Cody-ic/fpga-air-haptics/hardware/mechanical/P4_20261007/vertical_wrist.png

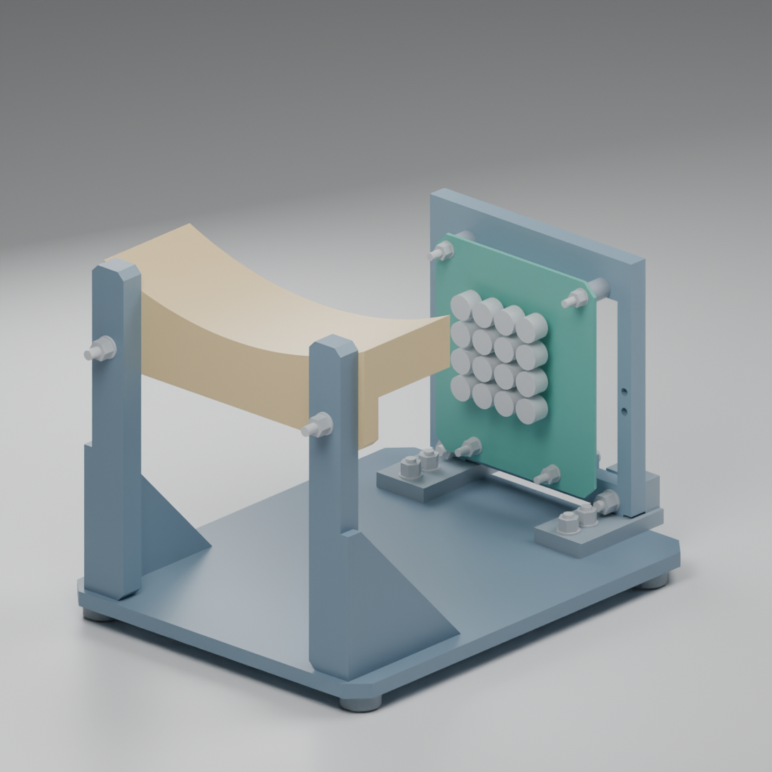
hardware/mechanical/P4_20261007/vertical_wrist.png
