Cody-ic/fpga-air-haptics/hardware/Haptics_4x4_R4_12VDC/核验报告.md

# 4×4 超声发射端 R4：12 V 电源保护与测试点

核验日期：2026-09-26。基于 R3 的独立副本修改，原始上传文件及 R3 保留。

## 修改内容

- **U25 改为 AMASS XT30PW-M20.G.Y 公头**，型号中的 `M` 表示公头。电源线端配套使用母头，避免带电线端露出金属针。原理图符号、PCB 封装和器件信息同时更新；重新调整安装位置及走线，使插接口朝向板边。
- 新增 **F1：0454.500MR，0.5 A 保险丝**；新增 **RT1：10D-9，冷态标称 10 Ω 的 NTC**，用于限制输入电容充电电流。
- 新增 **D1：SMBJ13A-13-F 单向 TVS**，阴极接保护后的 VCC，阳极接 GND。
- 新增 **19 个底面测试焊盘**：VIN、VCC、GND，以及 T00–T15。输出测试点通过短线接入对应输出网络，直径 1.524 mm，开放阻焊、不设置锡膏开口。
- 丝印更新为 R4，增加输入正负极与保险丝额定值。公头库封装中重复覆盖焊盘的铜层圆线移到文档层；保留焊盘、钻孔及机械位置。

## 电源与测试点

```text
U25.1 (+) → VIN_12V → F1 → VIN_FUSED → RT1 → VCC → C1 / 驱动器
                                                   └→ D1.K
U25.2 (-) → GND                                      D1.A → GND
```

| 测试点 | 连接网络 | 用途 |
| --- | --- | --- |
| VIN | VIN_12V | 测量保险丝前的输入电压 |
| VCC | VCC | 测量保护后的驱动电压及纹波 |
| GND | GND | 测量参考地 |
| T00–T15 | OUT0–OUT15 | 逐路检查输出频率、相位、幅度及过冲 |

U25 的 3、4 脚为封装固定脚，在原理图中标记不连接。未新增电子反接保护；XT30 的机械防呆不能防止线束正负极焊反。

## 软件核验

- 嘉立创 EDA Pro 严格原理图 DRC 与 PCB DRC 均为 **0 条错误**。
- 对比 78 个器件的原理图、PCB 引脚网络及封装关联，一致；保护链路已串入供电网络。
- 导出工程保留四个新增或替换器件；除 U25 外，原有 74 个器件的封装焊盘和孔几何与 R3 一致。
- Gerber 核查：19 个测试点均有底面阻焊开口，无对应锡膏闪孔；XT30 电源脚孔径约 1.90 mm，固定脚孔径约 1.10 mm。
- 保留 80 × 88 mm、4 层板、4×4 MA40S4S 阵列和原通道映射。当前有 93 个通孔过孔，以及原有 **32 个盲孔**：顶层至内层 1 为 8 个，内层 1 至底层为 24 个。生产需匹配该工艺，不能按普通全通孔四层板下单。

## 实物验证边界

本版完成设计文件核验，尚无实物测试。F1 的 0.5 A 为首版选值，需结合实际工作电流、启动电流及温升确认。NTC 会产生压降，热态再次上电时限流能力减弱；应同时测 VIN 和 VCC。

SMBJ13A 的反向工作电压为 13 V，数据手册额定脉冲下的最大钳位电压为 21.5 V；TC4427A 工作上限为 18 V、绝对最大值为 22 V。因此这里只将其作为小能量瞬态抑制措施，**不能宣称额定浪涌全范围保护，也不能接入 24 V 电源**。布线寄生与实际过冲仍需测量。

首次上电使用限流的 12 V 电源，先检查静态电流与 VCC，再逐通道检查 40 kHz 波形。输出为单端驱动，幅度取决于实际 VCC；声压、触觉效果及连续工作温升未验证。

## 文件

- [可编辑 EPRO 工程](Haptics_4x4_R4_12VDC.epro)
- [Gerber 复核文件](Haptics_4x4_R4_12VDC_Gerber.zip)
- [电源原理图](电源原理图.png)

## 9. 参考资料

- Microchip，2014：[TC4426A/TC4427A/TC4428A，DS20001423J](https://ww1.microchip.com/downloads/en/DeviceDoc/20001423J.pdf)，供电范围、绝对最大值及输入门限。
- Diodes，2017-05：[SMBJ5.0A–SMBJ200CA，DS19002 Rev. 20-2](https://www.diodes.com/assets/Datasheets/ds19002.pdf)，SMBJ13A 电压与脉冲参数。
- RUILON：[NTC 浪涌抑制器数据手册](https://atta.szlcsc.com/upload/public/pdf/source/20180410/C207392_007A1CB20DB6E487C695D7783FF0F5F9.pdf)，10D-9 参数。链接上传路径日期不等于厂商出版日期。
- 嘉立创器件库：XT30PW-M20.G.Y（C30170175）、0454.500MR（C179003）、10D-9（C70924）、SMBJ13A-13-F（C135042）；选型与封装资料核对日期为 2026-09-26。
