Cody-ic/fpga-air-haptics/hardware/mechanical/P5_lifts20_20261025/打印说明.txt

20 mm 增高垫打印说明（2026-10-25）

共2件，每个文件打印1个，按毫米单位、100%比例打印：
1. 13_receiver_tray_lift20.stl：接收板原托盘的增高垫，82.8×61.419×22 mm。
2. 14_film_stand_lift20.stl：薄膜原支架的增高垫，128.8×154.8×22 mm。

两件承托面都高20 mm，顶部另有2 mm定位挡边，所以文件总高22 mm。
平底朝下、挡边朝上；普通硬质塑料，建议层高0.2 mm、4道外壁、20%～25%填充、顶部和底部至少5层。无需支撑，保留薄膜垫中央的开口。

接收板继续固定在原05_receiver_flat_tray托盘内，整套托盘放到13号垫子上，不能把裸电路板直接放在新垫子上。
薄膜继续夹在原上下夹框内，连同原10_film_lower_stand四个脚一起放到14号垫子上；不要把膜片直接铺在新垫子上。
每次只放接收端或薄膜其中一种，不能叠放这两个新垫子。无需新螺丝、胶水或在原件上钻孔。
