Cody-ic/fpga-air-haptics/设计思路.md

# 触见：超声触觉图形显示器——设计思路

更新日期：2026-09-24

本文记录团队当前讨论形成的方案，用于分工、选型和联调。`desktop_app/` 已有可运行上位机、Demo 和双向串口客户端；FPGA、驱动及阵列仍为设计计划，尚无硬件实测。本文明确区分软件实现、参考模型和待验证目标，参数与接口需在联调后冻结。

## 1. 项目目标与范围

面向视障人群对基础图形和方向信息的感知需求，探索把简单形状和运动轨迹转化为手掌可感知的超声触觉刺激。首阶段验证“是否感觉得到、是否能区分简单图形”，不预先承诺复杂地图、精细轮廓或成熟无障碍产品能力。

| 已明确的方向 | 实现上仍待确定 |
|---|---|
| 主控选用 Tang Mega 60K，核心实时逻辑放在 FPGA | 实际底板版本、可用 GPIO、定点算法与时钟配置 |
| 保留外接 PCB 按键，预设图形可独立选择与播放 | 按键数量、指示方式、连接器和引脚 |
| 上位机采用 Python/Tk，HAP3 坐标路径协议已有客户端与 Demo | FPGA 固件实现、硬件回传时序与测量接口 |
| 以单焦点沿完整轮廓高速循环扫描为首版路线 | 工作高度、扫描参数、手部运动影响及可辨识图形 |
| 硬件先做 4×4，再扩展 8×8，256 路作为后续方向 | 换能器、驱动电路、模块尺寸及最终阵列规模 |
| 首版拟用可调腕托／定位凹槽与操作语音帮助放手 | 结构、工作高度、不同手型适配及语音播放载体 |

Tang Mega 60K 是 Sipeed 推出的开发板，使用高云 FPGA。GPIO 电平与接口复用应以实际板卡原理图为准，不能把不同连接器上的复用信号重复计数。资料入口见第 9 节。[1]

## 2. 系统架构

```mermaid
flowchart TD
    KEY[外接按键与状态指示 PCB] --> CTRL[模式仲裁与运行控制]
    PC[电脑上位机：配置、声场预测、数据分析] <-->|USB-UART| UART[串口解析与状态回传]
    UART <--> CTRL
    CTRL --> TRACK[预设图形存储与轨迹生成]
    TRACK --> PHASE[板内相位计算与校准补偿]
    PHASE --> BUF[相位双缓冲与统一更新]
    BUF --> OUT[载波、触觉调制及输出扩展]
    OUT --> DRIVER[独立驱动电路]
    DRIVER --> ARRAY[超声换能器阵列]
    CTRL -->|输出使能| OUT
    RX[接收器、测量前端与可选 ADC] -.扫描数据.-> PC
```

测量链路的接入方式尚未确定：初期可由示波器记录并导入电脑，后期再评估由 ADC 采样、FPGA 整理后经串口回传。没有测量硬件时，上位机只能显示计算结果和数字运行状态。

### 2.1 FPGA 和电脑的分工

- **FPGA**：处理按键与命令，执行轨迹，计算各通道相位，完成统一更新、载波输出和触觉调制；保存必要的运行状态。
- **电脑**：设置参数、选择图形、预览声场、下载轨迹、查看回传状态和分析测量数据。界面刷新与硬件实时输出解耦。
- **驱动电路**：把控制信号转换成适合所选换能器的电气激励。供电、电流能力和负载波形需单独验证。

独立运行是功能要求，但“拔掉电脑仍播放”本身不能证明相位计算发生在 FPGA。应通过 RTL 仿真、板端中间结果和资源报告说明计算实现；预存轨迹点与预存完整相位表也应明确区分。

### 2.2 本地模式与联机模式

下列规则已在上位机与 Demo 中体现，真实固件仍需实现与验证。

| 项目 | 本地独立模式 | 联机调试模式 |
|---|---|---|
| 配置入口 | 外接按键和板内预设 | 电脑串口 |
| 实时轨迹与相位计算 | FPGA | FPGA |
| 电脑断开 | 不影响已启动的本地任务 | 电脑尝试发送停止；板端心跳超时停止，Demo 阈值为 3 秒 |
| 图形来源 | 板内 ROM 或片内存储器 | 预设图形或一次下载并确认完整的轨迹 |
| 停止入口 | 本地停止键 | 本地停止键和串口停止命令 |

建议只允许在待机状态切换控制模式。本地停止键优先于所有启动命令；上电、复位后保持输出关闭，重新启动必须经过明确操作。串口连接或软件重连不能自动启动阵列。

## 3. FPGA 内部设计

### 3.1 数据通路

建议按下列边界拆分模块，具体命名在建立 RTL 工程时确定：

1. **输入与状态机**：按键同步及消抖、串口解析、模式仲裁、运行与错误状态。
2. **轨迹发生器**：上位机已有固定点、水平线、竖直线、圆、正方形、三角形和箭头；板端按验证进度逐项实现。参数包括中心、尺寸、播放速度和焦点高度。
3. **相位求解器**：由阵元坐标和目标坐标计算传播距离、相位，再叠加校准补偿；定点实现与电脑参考模型逐项对照。[3]
4. **缓冲与同步**：后台计算下一组相位，完整后统一切换；明确更新时刻，避免不同通道使用不同代参数。
5. **波形与调制**：产生载波与调制时序，协调输出使能；相位跳变和异常命令下的波形必须检查。
6. **状态回传**：返回当前模式、图形、已生效参数、相位更新计数、错误码及协议版本。

40 kHz 载波、至少 64 级相位量化、1～10 kHz 相位更新率可作为首轮评估参数，均不是已实现指标，也不作为触觉效果保证。最终选择取决于换能器、计算延迟、输出链路和测量结果。

区分三种频率：载波频率、相位更新率、整条轨迹重复率。例如每圈 100 个点、每秒更新 10,000 个点，在逐点匀速执行且无停顿时每秒重复 100 圈；不能把 10 kHz 写成图形重复率。

### 3.2 GPIO 扩展

先做真实的引脚分配表，再决定直连与并行移位链的比例。输出扩展应支持统一锁存或等效的同步更新，不预先固定“一个换能器占一个 FPGA 引脚”。

若采用逐时间片发送通道电平的移位方案，带宽预算为：

```text
单链净移位速率 = 每条链通道数 × 载波频率 × 每周期时间片数
示例：8 × 40,000 × 64 = 20.48 Mbit/s
```

该数值只计算有效数据，还需预留锁存和器件时序余量。若下级器件独立生成波形，必须按另一种接口重新计算。最终用器件数据手册和实测波形验证。

## 4. 硬件与外接按键

### 4.1 选型与 PCB

| 部件 | 计划用途 | 定型前需要确认 |
|---|---|---|
| 超声发射换能器 | 组成相控阵 | 频率响应、指向性、外径、额定驱动条件、批次一致性及供货 |
| 驱动器与输出扩展 | 激励换能器 | 逻辑电平、容性负载能力、输出幅值、温升和同步时序 |
| 接收换能器与前端 | 相对声场扫描、极性校准 | 频率响应、接收方向、增益、噪声、测量重复性 |
| ADC 或示波器接口 | 采集测量结果 | 采样链路、量程、带宽、同步方式和数据格式 |
| 手部位置传感器 | 后续随手调整焦点 | ToF 或摄像头方案的视场、延迟、遮挡与集成成本 |

首轮以 40 kHz 空气超声器件作为评估方向，具体型号尚未选定。先核对数据手册并测少量样品，再决定批量采购；不把此前讨论的示例器件视为最终 BOM。

PCB 工作按“单通道驱动验证 → 4×4/16 路小阵列 → 8×8/64 路 → 评估扩展”推进。若后续采用四块 8×8 模块拼接，要把模块边缘和接缝处的阵元坐标纳入布局与计算；同时规划电源分配、公共参考地、锁存时序、连接器、测试点和模块编号。

开发板接口按匹配的低压逻辑设计，不能把驱动电源送入 GPIO。驱动供电、换能器两端的峰峰值电压和电源输入电压须分别记录，具体限值遵守所选器件资料。

### 4.2 按键与指示

按键放在设备外接 PCB 上，经 GPIO 接入 FPGA，不依赖开发板自带按键。首版建议四个功能键：

| 功能 | 建议行为 |
|---|---|
| 上一个图形 | 切换待选编号，不直接改变正在运行的图形 |
| 下一个图形 | 同上 |
| 播放／暂停 | 待机时启动；运行时暂停并关闭刺激输出 |
| 停止 | 关闭输出并回到待机，优先级最高 |

速度加减键可预留，数量尚未冻结。状态指示至少区分待机、运行、联机和故障；显示选中图形及实际运行图形，避免两者混淆。

按键输入需要同步、消抖和单次事件检测；消抖时间由所选按键测试确定。软件停止与硬件驱动使能分别检查，不能把未经验证的普通按键称作硬件急停。

### 4.3 放手定位与操作语音提案

团队拟采用可调高度的腕托或定位凹槽，配合“手腕放入凹槽、手掌朝下”等语音，让视障使用者通过触摸与听觉找到放手位置。腕托放在阵列侧边并避开发声区域，支撑高度、伸入距离和不同手型适配通过实验确定；此前讨论的 15～20 cm 不作为冻结参数。

操作流程为摸到定位结构、选择图形、按键开始、暂停或停止。按键拟提供可触摸区分；语音载体与独立运行方式待选型。无位置检测时不声称手掌已到位，不自动启动。手部跟踪、方向纠正及移手暂停属于后续传感器方案，当前未实现。

详细流程、软件交互约定及验证任务见[交互与放手引导提案](交互与放手引导提案.md)。腕托与语音目前均为提案；软件手掌示意已实现，但不能替代实际放手引导或检测。

## 5. 电脑软件与串口联调

### 5.1 可视化内容

首版已实现，代码与操作说明见 [desktop_app](desktop_app/README.md)：

- 统一草图编辑器：连续直线、矩形、圆、拖动成圆弧和控制点曲线，可组合轮廓、擦除、撤销和重做，不用网格约束位置。
- 支持点重合、水平、竖直、平行、垂直及适用端点／圆之间的相切；不适用或冲突的关系按钮置灰，可从关系列表移除。矩形以相对关系保持形状，支持手柄／角度旋转；旋转保持尺寸，整体倍数缩放同步更新尺寸。
- 编辑与仿真共用完整手形坐标；编辑器默认突出掌面，以淡线露出部分指根，缩小视图自然显示更多手指。超出掌面参考较多时只提醒，保留发送能力；不以示意手形代替设备范围检查或触觉测量。
- 用户可排序或跳过排序。公共线按最终顺序只呈现一次；独立段之间关闭输出后跳转，手掌预览不生成多余连线。
- 默认普通界面提供图形编辑、保存载入和播放；调试模式提供相位、声场切片、设备能力、串口日志与测量导入。
- 常用图案通过顶部按钮选择，并预览待发送内容。端口和波特率在普通界面设置，连接期间锁定。
- 保存与导入显示文件名和未保存状态，替换草稿或关闭前提示；文件损坏及保存失败保留原内容，导入不自动发送或启动。
- 发送后显示设备确认；只有收到匹配配置及版本的状态后才启用播放。播放画面显示回传位置，修改图形或新连接需再次提交确认。
- 电脑发送完整配置、模式及播放命令；Demo 通过同一帧协议返回已生效配置、焦点与全部实际阵元的相位快照。
- Demo 阵列独立选择 4×4 至 16×16 等尺寸，真实阵列由板端声明。改变阵列不改变图形的物理坐标。
- 相位快照和日志可导出；接收器扫描值可通过 CSV 导入，采集链路尚未接入。

草图保存原始几何、关系、尺寸及轮廓顺序，电脑离散为最多 32 段、合计 256 个坐标后一次下发。单焦点沿各段插值，段间关闭输出；公共线先按几何范围去重。容量与换能器数量独立，按实际坐标和设备声明范围检查，1 µm 传输精度不等于定位精度。旧 64 点文件兼容导入；自由手绘、多焦点及完整 CAD 约束系统尚未实现。

软件区分**电脑草稿、Demo 模拟、FPGA 数字回读、理论重建与导入测量**。参考模型按各向同性点声源叠加，声速假设为 343 m/s，采用量化发送相位和相对幅值归一化；未模拟器件指向性、反射、调制包络或人体触觉阈值。热力图不能解释为声压实测、触觉强弱或辨识率。

当前 Demo 默认两秒一圈，用于看清路径与通信流程，仅在状态快照时计算理论焦点和相位；不是高速时序模拟。硬件计划由 FPGA 自主高速循环扫描完整轮廓，扫描参数、触觉效果及手移动时的适用条件尚需验证。不能把软件演示当作已经完成三角形等触觉辨识。

### 5.2 通信边界与协议草案

正常运行发送高层参数或提前下载轨迹，FPGA 本地执行实时循环。串口并非绝对不能传相位表：校准、低速验证和结果回读可以传；不能未经带宽评估就依赖串口连续传完整相位帧。

以 115,200 baud、8N1 为预算示例，10 个串行位承载 1 字节，理想有效数据上限为 11,520 字节/秒；若每通道占 1 字节，256 通道一帧，不计协议开销也只能传约 45 帧/秒。该示例说明此配置不适合作为 10 kHz 相位帧的数据源，并不限制高层命令控制。

当前采用 [HAP3 协议](desktop_app/PROTOCOL.md)，上位机和 Demo 已实现，尚无对应 FPGA 固件。命令类型包括 HELLO、CONFIG、MODE、START、PAUSE、STOP、SNAP 和 PING。完整握手报文示例：

```text
HAP3 CMD 1 HELLO*F6AD\n
```

`\n` 为 LF。帧包含序号及 CRC16，最大 8192 字节；坐标使用整数 µm，`scan_paths` 传送多段路径，`blank_us` 定义段间关闭输出的时间；`path_xy_um` 保留旧 64 点路径语义。STATE 增加 `scan_on` 和 `stroke_index`。完整图形与运行参数在一条 CONFIG 内提交，校验后原子生效，ACK 后再返回完整 STATE。未完整收到配置不得部分应用，连接及配置更新均不隐含启动。

HELLO 区分设备容量、实际安装阵列和命令坐标范围。STATE 返回启动标识、快照编号、配置版本、输出状态、焦点和全阵列相位；固件需锁存同一时刻的数据。Demo 运行时每 0.05 秒回传快照，其他状态每 0.5 秒回传；这是内存模拟传输，与板内高速更新频率及真实串口带宽独立。普通界面的播放画面由回传驱动，图形提交并收到匹配状态后才启用播放。异常、复位、版本不符及过期状态由客户端检测；REMOTE 失联依赖板端看门狗关闭输出，LOCAL 可独立运行。

### 5.3 手掌示意背景

已在图案预览与播放画面以手掌轮廓作为背景，叠加图形和焦点位置，保留图形坐标及回传数据来源。矢量轮廓采用固定参考坐标，与图形共同缩放，不将偏移或过大的图形自动移入掌心。界面明确标注“手掌示意 · 非位置检测”；当前未接入手部检测，焦点回读不能作为真实手掌位置。示意图用于演示，视障使用者的实际放手引导仍需第 4.3 节拟定的结构与语音。

## 6. 分阶段验证与交付

以下为建议安排，不代表已完成进度。按原调研所记录的 2026-11-04 提交节点倒排，赛事日期、报名状态及高云赛道对第三方板卡的要求仍需在报名系统核实；该节点未在本次更新中重新核验。

| 阶段 | 建议时间 | 阶段出口 |
|---|---|---|
| 接口与选型 | 2026-09-24 至 2026-09-30 | 原理图候选、GPIO 表、按键与串口回读；低压相位输出可测 |
| 驱动与 4×4 小阵列 | 2026-10-01 至 2026-10-10 | 单通道电气记录；16 路相位与极性正确；完成相对声场扫描 |
| 64 通道与整机联调 | 2026-10-11 至 2026-10-20 | 聚焦位置可重复、校准流程可用；评估触感及扩展条件 |
| 扩展与量化 | 2026-10-21 至 2026-10-28 | 根据结果决定是否扩展；记录独立运行、计算性能及辨识结果 |
| 演示与材料 | 2026-10-29 至 2026-11-03 | 固定演示版本、报告、视频和已知限制 |

安排需结合器件交期调整，并为改板留出余量。64 路触感不足时，应先排查驱动、极性、声场和调制，再决定扩阵列；不能把“64 路必须摸得清图形”作为扩展前提，也不能未经测量就认为增加阵元一定解决问题。

验证按层归属负责人，不设置只负责测试的独立岗位：

- **数字逻辑**：相位计算误差、频率、统一更新、按键与串口仲裁、错误命令和复位行为。
- **电气与声场**：负载电压、电源电流、温升、通道一致性、焦点坐标和相对分布。未经校准的接收幅值只作相对量，不能标成准确的 Pa 或 dB SPL。
- **整机与体验**：本地离线操作、联机超时停止、连续运行、随机化图形辨识、正确率和辨识时间；定位样件另记录放手时间、协助次数、重复偏差和语音理解情况。记录参与条件和样本数，区分普通体验测试与视障用户验证。

各项记录保留板卡、固件、阵列布局和测试条件。触觉体验应在电气检查和超声暴露条件评估后开展，不能仅凭“听不见”认定适合人体测试。

## 7. 协作与近期决策

建议三人分别主责 **FPGA 与算法、硬件与阵列、上位机与系统集成**，各自承担模块验证，整机联调共同参与。具体成员分配由团队决定。

开始 PCB 定版前先完成：

1. 核对到手 Tang Mega 60K 的底板版本、原理图和空闲 GPIO。
2. 确定换能器样品、阵元间距、驱动拓扑和测量工具。
3. 约定坐标原点、轴方向、通道编号、极性标记及模块拼接位置。
4. 统一 FPGA 与电脑的定点单位、相位定义和串口字段。
5. 确定本地按键行为、联机心跳和输出关闭路径。
6. 用可调定位样件验证放手方式，确定语音触发与播放载体；不要仅凭屏幕手掌图案判断引导完成。

芯片资源、精度、刷新率、器件成本与用户效果都要用实现或实测支撑。已有 Zynq 研究已经包含板内相位加速，因此不能把“相位在 FPGA 内计算”单独称为首创。[3]

## 8. 后续扩展

在首版可重复运行后，按价值与工作量逐项选择：手部位置跟踪、语音图形讲解与分步教学、教师教学素材管理、多焦点、简化地图与方向提示、虚拟按钮及操作反馈。基础放手与操作语音已纳入首版交互提案，尚未实现；任意坐标自定义绘图已在上位机实现。

声悬浮需要单独的声场与结构验证，不作为本作品的默认保底演示。[3] 扩展项目不能挤占单焦点触感、独立操作和性能记录的完成时间。

## 9. 参考资料与核验范围

以下资料用于技术依据与实现参考，2026-09-24 查阅；不代表本项目已经复现。

1. [Sipeed Tang Mega 60K 官方说明](https://wiki.sipeed.com/hardware/zh/tang/tang-mega-60k/mega-60k.html)：核对板卡型号、GPIO 电平、接口复用及工具要求。
2. [Sipeed TangMega-60K-example](https://github.com/sipeed/TangMega-60K-example)：板卡入门与外设示例，使用时记录实际版本。
3. [High-Performance Ultrasonic Levitation with FPGA-based Phased Arrays](https://arxiv.org/html/1901.07317v2)：相位计算、FPGA 加速与声场测量参考；声悬浮结果不能直接换算为本项目的触觉效果。
4. [SonicSurface 官方仓库](https://github.com/upnalab/SonicSurface)：开放阵列的算法、电子硬件、固件和结构资料，涉及触觉与声悬浮等应用。

换能器与驱动器型号、人体触觉效果、具体采购成本、2026 年高云赛道规则及日期尚未在本方案中完成核验，不能据此承诺成品性能或参赛资格。原始赛事与选题资料保留在 `FPGA赛道选题建议(1).md` 第 9 节。
