Cody-ic/fpga-air-haptics/desktop_app/README.md

# 触见图形工作台

桌面上位机，提供轻量草图编辑、图形保存、手掌预览、无硬件 Demo 和双向串口。默认界面用于绘图和播放，勾选“调试模式”后可查看相位、理论声场、设备参数和通信日志。FPGA 固件与实体板卡联调尚未完成。

界面示例：[草图编辑](docs/sketch.png)、[掌面与缩小视图](docs/palm-zoom.png)、[手掌预览](docs/sketch-preview.png)、[播放反馈](docs/playback.png)、[基本图案预览](docs/presets.png)。

绘图区、图案预览和播放画面共用同一只手的轮廓与毫米坐标。编辑器以淡线显示，默认放大掌面，手指自然延伸至画布外；缩小视图会逐渐露出更多手指。示意尺寸未经人体数据标定，不代表平均手掌、手部测量或有效触觉范围。实体引导见[交互与放手引导提案](../交互与放手引导提案.md)，腕托、语音和手部跟踪尚未实现。

## 启动

Windows 64 位便携版：双击 `desktop_app/dist/触见图形工作台.exe`，无需安装 Python。给队友分发时使用同目录的 `TouchSee-Windows-x64.zip`，内含程序、使用说明、构建信息与依赖许可。首次启动需要解包运行库，请稍等；程序不需要管理员权限。构建产物保留在本地，不提交到 Git。

使用 Python 3.10+（含 Tk），在仓库根目录执行：

```powershell
python -m pip install -r desktop_app/requirements.txt
python -m desktop_app --demo
```

本机桌面快捷方式 `触见调试台.lnk` 指向已打包的 `.exe`，带 `--demo` 参数，自动连接模拟设备但不播放。直接双击 `.exe` 或省略 `--demo` 则先离线编辑。源码仍可使用 `D:\python\python.exe` 运行。

### 构建 Windows 可执行程序

在 Windows 上使用 64 位 Python 3.10+，建议建立独立构建环境：

```powershell
python -m venv desktop_app/.runtime/build-venv
desktop_app/.runtime/build-venv/Scripts/python.exe -m pip install -r desktop_app/requirements-build.txt
powershell -NoProfile -ExecutionPolicy Bypass -File desktop_app/build_windows.ps1 -Python desktop_app/.runtime/build-venv/Scripts/python.exe
```

脚本使用 PyInstaller 生成单文件窗口程序，同时生成便携 ZIP 与 `build-info.json`（记录实际依赖版本及 EXE 的 SHA-256）。只打包 TkAgg 绘图后端；输出目录 `dist/` 和构建缓存 `build/` 均被 Git 忽略。打包版启动错误写入 `%LOCALAPPDATA%\TouchSee\logs\startup-error.log`，不写入临时解包目录。

打包后可执行以下自检，运行可见 Demo 流程并自动关闭，不连接真实串口：

```powershell
Start-Process -FilePath 'desktop_app/dist/触见图形工作台.exe' -ArgumentList '--self-test desktop_app/.runtime/frozen-check' -WindowStyle Hidden -Wait
Get-Content desktop_app/.runtime/frozen-check/gui-smoke.json
```

自检覆盖绘图、尺寸与关系、保存导入、发送确认、播放、阵列切换和回传超时。报告中 `passed` 应为 `true`；截图写入指定目录。已在本机从仅含 EXE 的独立目录、移除 Python 环境路径后通过此检查；真实板卡联调仍待硬件。修改源码后需要重新构建，桌面快捷方式才会运行新版。

## 绘制与保存图形

1. 用“连续直线”依次点击画折线，点击起点闭合；右键或 Esc 完成。原来的点选连线已合并为这个工具，没有独立打点模式。位置不吸附网格，靠近已有端点时可连接。
2. 用“矩形”“圆”点击两处或拖动绘制，在同一画布组合图形。“控制点曲线”依次点击起点、两个控制点、终点，生成三次 Bézier 曲线；曲线不要求穿过控制点。
3. 选择后拖动端点调整位置、拖动直线改成圆弧、拖动曲线手柄塑形；“移动”平移元素。“擦除”或 Delete 删除整条线／整段圆弧／整条控制点曲线，支持撤销和重做。暂不提供交点间局部修剪。滚轮缩放、“适合窗口”只改变视图。
4. 点击“保存图形”选择名称和位置，文件保存为 `.json`。左侧显示当前文件名与是否有未保存的更改，底部提示完整保存位置。
5. 点击“导入图形”选择已保存的 `.json`，恢复图形与参数；文件选择窗口记住本次运行中上次使用的目录。也可用 `Ctrl+O` 导入、`Ctrl+S` 保存。
6. 导入、读取设备图形或关闭窗口时，若有未保存的修改，可先保存、放弃更改或取消。文件损坏不会覆盖当前草稿，保存失败不会覆盖原文件。

导入只改变电脑上的待发送图形，不会发送命令或启动设备。要播放，先停止当前输出，点击“发送到设备”，收到确认后再播放；即使导入内容与设备相同，也需要再次发送确认。

### 几何关系、尺寸与顺序

- 选择工具中，按住 Shift 选两个点，在“关系”页点“重合”；也可把一个端点拖到另一个点上。重合会持续保持，支持保存与撤销；同一条线的两端不能重合。
- 选择直线可设水平、竖直；Shift 多选两条直线可设平行、垂直。相切支持直线与圆、两个圆，以及共同端点处的直线／圆弧／控制点曲线。切点落在线段延长线上会拒绝；圆与控制点曲线的任意位置相切尚不支持。
- 不适用、已添加或求解冲突的关系按钮置灰；鼠标指向按钮可查看原因。取消关系：选择相关点／线条，打开“关系”页，选中列表中的一项，再点“移除选中的关系”。取消重合时，依赖该连接的相切关系也会移除；支持撤销。
- 双击选中整个轮廓，拖绿色手柄旋转，按住 Shift 按 15° 调整；也可在“尺寸”页输入旋转角度，正数逆时针、负数顺时针。矩形默认保持对边平行、邻边垂直，允许任意朝向。旋转保持尺寸，宽高标注方向随图形一起转动。手动水平／竖直关系或外部连接阻止旋转时会提示，不擅自删除关系；旧文件中的矩形方向关系可按上述方式移除。
- 单击选线，双击选整个轮廓。“尺寸”页显示对象名称、当前值和尺寸含义，只提供适用选项：直线长度、圆／圆弧半径与直径、曲线／整个轮廓的宽度和高度。矩形双击后可改整体宽高，图上显示已设标注。尺寸作为持续关系保存；整体倍数缩放以草图原点为中心，同时更新几何和已设尺寸，整体偏移与显示高度不变。冲突修改会拒绝，可在“关系”页移除关系后再编辑；不要求完全定义。
- 在“顺序”页选中轮廓后上移、下移；跳过排序采用稳定的创建顺序。新增／删除轮廓后恢复自动排序。开放线条也保留，不擅自补闭合边。
- 尽量避免闭合轮廓共边。按最终顺序减去已经呈现的重合部分，后续轮廓可能分成多段。直线、同圆圆弧和相同 Bézier 曲线的重合区间在离散前处理；交叉点不算公共线。独立段之间关闭输出再切换。
- “手掌预览”查看完整待发送图形，不发命令；播放位置来自设备回传，切换线段时隐藏触觉亮点。手掌仅为示意，不是位置检测。

### 手掌参考与绘图范围

画布以掌面为主要区域，背景保留完整手形，手指只显示当前视野内的部分。白色画布基本都可落点，包括靠近顶部和手掌外的位置；边缘仅保留少量留白。滚轮缩放视图时，图形和手同步缩放，缩小后自然露出更多手指；“适合窗口”恢复掌面与草图视野，均不修改实际坐标。

明显超出掌面时显示黄色提醒，不禁止发送、不弹确认框、不自动裁剪。当前提醒给掌面参考留出 10 mm 余量，检查整条曲线和整体偏移；手指与伸出的拇指不计入主要掌面。此余量只是界面提示规则，实际手掌较大的使用者可以忽略。设备声明的命令范围与容量仍需满足。

“放入掌面”由用户主动点击，将整张草图等比例缩小（不放大）并移到掌面中央，尺寸同步更新，可撤销。“整体缩放”改变图形实际大小，手掌参考不变，与滚轮缩放视图含义不同。

草图保留可编辑几何，电脑以 0.1 mm 几何离散阈值生成折线，最多 32 段、合计 256 个路径坐标；过于复杂的图形会要求简化，不静默截断。旧路径文件保留原 64 点限制。整数微米传输精度、路径容量与阵元数量均不代表触觉定位精度或辨识能力。

顶部图案按钮提供固定点、水平线、竖直线、圆、正方形、三角形和箭头，点击即可预览。“自定义”返回草图，切换预设不会丢失草图。

“水平偏移”“垂直偏移”平移整张图形，“显示高度”设置所在平面。左侧半径只影响预设图形，正方形使用半边长。新文件为 `haptics-config-3`，保存控制点、几何关系、尺寸、顺序及对应路径，并在导入时校验一致性。旧网格／点列文件可迁移，未经编辑时保留原播放语义。设备只回传编译后的路径，无法恢复未上传的原始几何关系；保存原草图文件可保留完整编辑能力。

## 连接与 Demo

1. 选择 Demo 并连接，在画布绘制一个三角形。
2. 点击“发送到设备”，自动打开“播放画面”。收到确认前，“播放”置灰；收到匹配的完整图形回传后，显示“图形发送成功，可以播放”。只连接设备或只收到命令应答不会解锁按钮。
3. 点击“播放”，亮点按模拟设备返回的位置移动，默认两秒一圈；暂停后保留橙色位置标记，停止后只保留轮廓。修改图形后需重新发送，断开或回传过期会隐藏位置并禁用播放。普通模式即可看到完整反馈；相位和理论声场仍在调试模式。
4. 停止并断开，在“设备设置”将 4×4 改为 8×8，重新连接、发送和播放。同一图形坐标不变，回读相位由 16 路变为 64 路。
5. 停止后选“设备按键控制”，通过调试模式的 Demo 按键切图与播放，观察回传变化。勾选“模拟回传中断”可验证超时。重连 Demo 会创建新的待机设备。

设备设置提供 4×4、6×6、8×8、12×12、16×16 及自定义 1～16 行列，默认阵元间距 10 mm。手动设置仅用于 Demo 和离线预测，真实设备尺寸由握手读取。

图形设计与阵列大小独立；使用所有实际阵元计算单焦点相位。发送前检查实际坐标是否在设备声明范围内、路径是否超过容量、阵列声明是否一致；超出范围不会自动裁剪或缩放。命令接受范围不等于已验证的触觉有效范围。

## 扫描路线与演示边界

当前按**单焦点沿完整轮廓高速循环扫描**规划硬件。电脑一次提交完整图形，FPGA 应独立完成插值、相位求解和更新；不依赖电脑实时逐点发送。

Demo 只在取快照时计算当前位置和相位，没有高速硬件时序。运行时每 0.05 秒回传一次，其他状态每 0.5 秒回传一次；这是内存模拟传输，不代表真实串口支持相同数据量。播放画面的亮点使用最新收到的位置，不在电脑自行补算真实设备的运动。它默认慢速播放，不能用动画流畅度或通信成功证明人能辨认图形。实际扫描参数、手部移动影响和辨识率都需要样机实验；多焦点与手部跟踪仍为后续方向。

## 调试与数据来源

| 页面 | 用途与边界 |
|---|---|
| 图案预览 | 在手掌示意上预览待发送图案，不改变设备输出 |
| 播放画面 | 普通模式可见；在手掌示意上显示设备收到的图形、运行状态和回传位置 |
| 设备回读 | 显示收到的已生效配置、焦点及全阵列相位；声场根据该快照计算 |
| 电脑预测 | 预览尚未发送的参数；使用连接设备的阵列，离线时使用设备设置中的阵列 |
| 实测数据 | 导入 `x_mm,y_mm,value` CSV；接收值须有限、非负，最多 5 MB／50000 行 |
| 通信日志 | 查看收发与错误，保留最近 3000 条，可导出 JSONL |

相位 CSV 标明 DEMO 或 FPGA 数字回读来源、快照编号、数据年龄和每通道坐标。传感器 CSV 的来源与校准由数据提供者确认，Demo 不生成测量数据。

`model.py` 使用各向同性单频点声源叠加，声速假设为 343 m/s，幅值按理想相干和归一化。输出等级仅作线性比例，未模拟器件指向性、反射、驱动电压、调制包络或人体感知，数值不是 Pa、dB SPL 或触觉强度。

## 真实设备与协议

界面示例：[常用及自定义波特率](docs/baud-options.png)。

切换“真实串口”，在顶部选择 COM 端口和波特率后连接，默认 115200 baud，需与板端一致。普通界面提供 1200、2400、4800、9600、19200、38400、57600、115200、230400、460800、500000、921600、1000000、1500000、2000000、3000000 等常用选项，也可直接输入其他正整数。下拉选项不代表适配器或 FPGA 支持全部速率；连接后需先断开再修改，Demo 不使用波特率。固件需实现 [HAP3 协议](PROTOCOL.md)，包含多段路径、跳转时关闭输出及对应状态回传；拒绝 HAP1／HAP2 固件，不自动回退为 Demo。固件须按串口带宽安排回传周期，低速率可能导致复杂图形的回传超时，不能照搬内存 Demo 的回传频率。

配置只能在电脑控制且待机时修改，控制来源只能在待机时切换。发送成功不代表状态已确认：客户端等待 ACK 和后续完整 STATE。REMOTE 断开尝试发送 STOP，失联后的关闭依赖板端看门狗；LOCAL 断开保留独立运行。界面状态未知时不能确认硬件已停。

## 开发与验证

```powershell
python -m unittest discover -s desktop_app/tests -v
python -m desktop_app.tests.gui_smoke
```

测试覆盖重合与取消、旋转及尺寸保持、关系预检、掌面提醒、公共线去重、曲线编译、关闭输出的跳转、协议与文件迁移；GUI 场景覆盖点选／吸附重合、关系置灰、旋转手柄、缩小视图露出手指、提醒不阻止发送、保存导入、手掌预览、发送确认、4×4/8×8 回读和超时。截图需 Pillow，写入被忽略的 `.runtime/`。真实串口适配器有模拟测试，尚无板卡联调结果。

代码分工：`sketch_editor.py` 草图交互，`sketch.py` 几何关系与编译，`editor.py` 画布裁剪，`presets.py` 图案预览，`playback.py` 设备反馈，`hand_view.py` 手掌示意，`model.py` 路径与声场参考，`app.py` 界面与文件，通信模块见协议说明。
