Cody-ic/fpga-air-haptics/hardware/mechanical/P5_school_20261020/学校打印需求.md

# 学校 3D 打印需求单

日期：2026-10-20。适用 **P5：上方发射板、下方独立接收托盘**。
本次保留 4×4、8×8 两种承载框，两块发射板各自预装，**共用一套左右侧架**。
不打印第二套支架，不改模型尺寸。

## 本次只补打 11 件

上次学校将原包的 **7 种模型各打印了 1 件**。原有件全部保留，本次补齐以下数量：

| 零件 | 最终总数 | 上次已有 | 本次补打 |
|---|---:|---:|---:|
| 共用侧架 | 2 | 1 | **1** |
| 4×4 发射承载框 | 1 | 1 | 0 |
| 8×8 发射承载框 | 1 | 1 | 0 |
| 发射板背面绝缘套筒，外径 6、高 5 mm | 8 | 1 | **7** |
| 独立接收平底托盘 | 1 | 1 | 0 |
| 接收板短压片 | 4 | 1 | **3** |
| 孔径试片 | 1 | 1 | 0 |
| **合计** | **18** | **7** | **11** |

套筒共 8 个，是两块发射板**每块 4 个**；不是给一块板装 8 个。
最终为 17 件正式零件加 1 件试片。试片已计入总数，不另加一件。
原装配清单中的 4 个套筒对应单块发射板；本单明确采用两块板各自预装的数量。

## 交给学校哪个包

- **这次补打只交** `TouchSee_P5_School_TOPUP_11pcs_20261020.zip`：里面恰好 11 个模型文件，**每个文件打印 1 件，总计 11 件**。
- `TouchSee_P5_School_FULL_18pcs_20261020.zip` 仅供以后从零打印完整套件：18 个模型文件，每个文件打印 1 件。**本次已有 7 件，不用这个全量包。**
- **两个包不能一起打印。** 不再将旧的 7 文件模型包当作数量清单。

同形零件已按数量拆成独立文件。例如套筒的 `02of08` 到 `08of08` 都要打印，
即使形状完全相同也**不要去重**。这些都是独立零件，不要拼接、合并或黏成一体。

## 打印要求

1. 只打印所选包内 `stl/` 文件夹的文件；每文件 1 件，按文件逐件清点。
2. 单位为 **mm，比例 100%**。保留模型原尺寸和打印朝向，不整体缩放、不镜像；两侧架用同一个模型的两个副本。
3. 使用学校可提供的塑料打印材料；具体材料和切片参数由打印老师结合设备确认。最大件约 **182×190 mm**，设备放不下时先反馈，不能缩小整套模型。
4. 保留通孔、螺母槽、接头缺口和底部凹腔。完成后清除临时支撑、拉丝及孔口毛刺，不把孔或槽封死。
5. 先用已有孔径试片确认螺钉配合。新套筒不得明显歪斜或堵孔，压片要分别交付；有尺寸或配合问题先反馈，不通过整体缩放修正。

## 交付时如何清点

本次应收到 **1 个侧架 + 7 个套筒 + 3 个压片 = 11 件**，按三类分袋标注。
加上上次的 7 件后，按上表逐项验收为 18 件。若原有件丢失、损坏或原包并非 P5，先重新核对已有数量。

**螺钉、金属螺母、垫圈、电子板、换能器以及线缆都不需要 3D 打印。**
参考模型不在学校包里。打印数量变化不修改原来的结构或装配方式。

## 另备标准件，由我们采购

按两块发射板各自预装、共用侧架计算：M3×25 螺钉 8 颗、M3 尼龙锁紧螺母 8 颗；
M3×16 螺钉 4 颗、普通 DIN 934 M3 螺母 4 颗；M3 平垫圈共 20 片；
M4×30 螺钉 4 颗、M4 尼龙锁紧螺母 4 颗、M4 平垫圈 8 片。
接收托盘使用普通 M3 螺母，不能换成更高的尼龙锁紧母。装配方法沿用 P5 装配清单。
