Cody-ic/fpga-air-haptics/FPGA赛道选题建议(1).md

# 全国大学生嵌入式芯片与系统设计竞赛 FPGA 创新设计赛道 选题建议

整理日期：2026-09-04（选题部分于同日修订为场景优先版）
适用赛季：2026 年（第十届 FPGA 创新设计赛道）

> 2026-09-24 状态补充：团队已选择第 6.2 节触觉图形显示方向，当前设计见 [设计思路](设计思路.md)。本文保留早期调研记录，推荐排序、竞赛检索结论及性能目标不代表当前决策或实测结果；原文对既有 Zynq 方案的板内相位计算能力表述不准确，修正说明见设计思路第 7、9 节。

---

## 1. 赛事概况与 2026 时间节点

| 事项 | 时间 |
|---|---|
| 报名截止 | 2026-09-22 24:00 |
| 作品设计期 | 2026-09 至 2026-11-04 |
| 作品提交截止 | 2026-11-04 18:00 |
| 全国决赛 | 2026-11-20 至 11-22 |

基本规则：

- 每队不超过 3 人，不超过 2 名指导老师，分本科生组和研究生组。
- 报名后组委会按"信息完整度、创新性、科学性、工程可行性、设计难度、FPGA 平台适用度"审核参赛资格。
- 初赛线上评审作品报告和视频，决赛现场演示加答辩。
- 决赛要先通过 FPGA 基础编程能力考核，才有评奖资格。
- 一等奖不超过 100 个，二等奖不超过 200 个，另设最佳创意奖、最佳工程奖各不超过 3 个，企业特别奖由协办企业评选。
- 协办企业：AMD、安路科技、高云半导体、易灵思、紫光同创，2026 年通知中还出现了复旦微、中科亿海微。

板卡获取：

- 安路：报名后填写板卡申请表，免押金借用，提交有效作品后板卡不退。每队只能免费申请一种平台。
- 紫光同创（2025 版政策）：提供约 200 套盘古 50 和盘古 676 借用，RK3568 异构板 10 套，未借到可淘宝折扣购买。
- 易灵思：官方按报名人数分配开发板，未分到可 8 折购买。

官网：http://www.fpgachina.cn/ 和 https://www.socchina.net/

---

## 2. 各厂商赛题方向

### 2.1 安路科技（2026 版，已发布）

| 选题 | 推荐平台 | 核心要求 |
|---|---|---|
| 一、EG4S20 HDMI 多媒体播放系统 | HX4S20C（EG4S20，19.6K LUT） | TF 卡读 BMP、SDRAM 帧缓存、HDMI 音视频输出，加分项：图层叠加、转场、缩放、OSD、音频可视化 |
| 二、PH1P35 实时数字图像处理系统 | HX1P35A（PH1P35，38K LUT，MIPI 输入） | MIPI 采集到 HDMI 显示，至少 1 种硬件图像算法，OSD。加分项：多算法切换、目标跟踪、处理延迟可视化、帧差运动检测、自动曝光/白平衡 |
| 三、图像采集压缩与智能预处理加速 | MLK-AFH03-AFC03（PH1A90 + RK3576） | 必做：MIPI 驱动 IP、3 种硬件预处理、JPEG/LZ77 硬件压缩、FPGA 与 RK3576 高速通道、NPU 推理、量化测试报告 |
| 四、飞龙 SoC 智能工业应用系统 | MLK-F3P-DR1M90G（DR1，A35+FPGA+NPU） | 必做：PL 端多轴 PWM 伺服/多通道同步采集/工业总线解析三选一、PS 端 Linux 界面、AXI 交互、NPU 推理、CAN/RS485 |
| 五、自主命题 | 不限板卡 | 按创新性、趣味性、实用性综合评判 |

安路 2026 评分口径中值得注意的话：

- "扣分：全部功能仅 PS 软件实现"、"扣分：算法仅软件实现、未做流水线并行"、"扣分：压缩模块依赖软编码"。
- 扩展项不设固定分值，按完成数量、技术难度、实现质量、稳定性、现场展示综合评分。
- 参赛作品支持开源，允许主办方用于教育用途。

### 2.2 紫光同创（2025 版，2026 版需到官网下载中心核对）

| 选题 | 评分要点 |
|---|---|
| 一、仪器仪表：智能信号分析与测试系统 | ADC 采集、1024 点 FFT、幅值/频率/占空比/THD，扩展：双通道相位差、自动测试；创新：锁相放大微弱信号检测、AI 波形识别、无线控制 |
| 二、智能制造：缺陷检测与空间定位 | 缺陷识别精度与实时性 40 分、空间定位精度 30 分、人机交互与 PLC 联动 20 分、FPGA 加速效果 10 分 |
| 三、视频图像处理：软硬协同机器视觉（RK3568_MES2L50H） | 提升功能 70 分，其中"实时识别的目标种类数与同步标记路数"占 40 分，准确率、帧率、算法复杂度各 10 分 |
| 四、自主命题 | 示例：FPGA 游戏机、工业以太网 + FOC、CPRI/JESD204B/NVMe 等高速接口实现 |

推荐板卡：盘古 50（PGL50H，40nm）、盘古 676（PG2L100H/200H，HDMI 收发各 1 路，8 路 6.6 Gbps SerDes，PCIe）、PGX-Nano（PG2L50H，板载 ESP32 无线、8bit DAC）、RK3568_MES2L50H 异构板。配套模块：OV5640 双目摄像头、MS9708 8bit 125 MSPS DAC、MS9280 8bit 35 MSPS ADC。

### 2.3 高云半导体（2024 版风格参考）

题目一贯偏硬核、参赛人少：ISP 系统设计、2 Gbps 以上高速信号采集、高精度音频处理与效果生成、Mini LED 分区背光驱动。2022 年题目是语音关键词识别、声场摄像头、目标识别。推荐 Tang Mega 系列，也允许第三方高云芯片板卡。

### 2.4 易灵思（2025 版）

四个命题由奥唯思拟定：2mm 内窥镜图像开发、畸变矫正算法、众脸识别加速、T20 ADC UI 开发，同时允许自命题。板卡 Ti60F100/F225 系列。

### 2.5 AMD

分自主命题赛道和命题式基础赛道，另有国际赛道对接 IEEE FPT 设计竞赛。器件覆盖 Spartan 7、Zynq、MPSoC、Versal。

---

## 3. 往届优秀作品盘点

| 年份 | 作品 | 学校 | 平台 | 奖项 | 亮点 |
|---|---|---|---|---|---|
| 2025 | 鸟类声音识别系统 | 武汉大学 | 安路 DR1 | 一等 + 最佳创意 | FPGA 端声音提取识别，ARM 端跑模型，面向生物多样性研究 |
| 2025 | 众脸识别加速器 | 武汉大学 | 未注明 | 一等 | 多人脸并行识别加速 |
| 2025 | 多模态智能人机交互系统 | 南京大学 | 安路 DR1 | 一等 + 安路杯 | PL 做机械臂关节实时高精度控制，PS 做多模态感知决策 |
| 2025 | 多模态四探针半导体测试仪 | 广西大学 | 安路 DR1 | 一等 + 安路杯 | FPGA 并行测量工艺参数，CPU 做界面 |
| 2025 | 基于 Zynq 的声学相机 | 西安交通大学 | XC7Z020 | AMD 赛道展示作品 | 双路差分插值流水波束形成，每秒 3 万次定位，2.5° 精度 |
| 2025 | DSRNet 医疗影像超分 | 合肥工业大学 | A7-100T | AMD 赛道展示作品 | 自研轻量网络手写 Verilog，推理约 300 µs |
| 2025 | 大模型推理加速 | 南京大学 | AMD | AMD 赛道展示作品 | 解耦计算、定制算子和宏指令集 |
| 2025 | 网球球童机器人 | 西安邮电大学 | Zynq-7010 | AMD 赛道展示作品 | 图像加速 + 运动控制 + 蓝牙 |
| 2025 | 信号分析仪器 | 未注明 | 高云 | 一等 | 决赛追加 CAN、频响分析、谐波生成 |
| 2025 | 以太网数据传输系统 | 中国石油大学（华东） | 安路 | 一等 | 命题基础题做到高完成度 |
| 2024 | 视频无极缩放 Ultra-Vision | 南京大学 | 易灵思 Ti60F225 | 一等 + 易灵思杯 | 2K@50Hz，逐像素缩放步长，算法直出 HDMI 不回写 DDR，三种插值可切换 |
| 2024 | 陀螺仪姿态投影实时矫正 | 南京大学 | AMD | AMD 杯 | 投影仪姿态变化时实时几何校正 |
| 2024 | 高云 FPGA 脑电分析设备 | 江南大学 | 高云 GW5AST | 一等 | 1dCNN+LSTM 预测，2dCNN 检测癫痫脑波，多采样率输入 |
| 2024 | 红外眼动识别与追踪 | 天津工业大学 | 易灵思 Ti60F100 | 一等 | 850nm 窄带滤光，积分投影定位 |
| 2024 | PYNQ 三维医学图像重建 | 东南大学 | Zynq MPSoC | 一等 | HLS 加速实时三维渲染 |
| 2024 | Diffuser | 东南大学 | 未注明 | 一等 | 扩散模型相关加速 |
| 2024 | 多路异构信号采集存储分析 | 苏州大学 | 紫光盘古 50 | 一等 | 多路不同信号同步采集与分析 |
| 2024 | 面向导盲的 YOLO 加速系统 | 中国海洋大学 | AMD | 三等 | 说明纯 YOLO 加速竞争激烈 |
| 2023 | 多路网络视频监控编码系统 | 开源项目 | 高云 | 高云赛道 | 采集端、编码端、上位机三部分，GitHub 开源 |
| 2022 | FPGA 上的 RISC-V 开发平台 | 重庆邮电大学 | 未注明 | 一等 | 软核 + 工具链 + 外设生态 |
| 2020 | 在线会议智能话语者搜索聚焦 | 武汉大学 | Xilinx | 一等 + Xilinx 杯 + 最佳创意 | 麦克风阵列声源定位联动摄像头聚焦 |
| 2020 | 激光雷达点云快速拼接 IP | 武汉大学 | Xilinx | 一等 | 点云拼接硬件 IP 加车载演示 |
| 2020 | 多帧融合智能相机 | 武汉大学 | Xilinx | 一等 | 多帧融合图像增强 |

---

## 4. 从获奖作品提炼的规律

1. **最佳创意奖看场景新不新**。鸟声识别、话语者聚焦技术上都不是最难的，赢在应用切口。
2. **企业杯看有没有吃透这颗芯片**。无极缩放赢在绕开 DDR 回写的架构设计，DR1 获奖作品都是 PL 做硬实时、PS 做决策的清晰分工。
3. **一等奖普遍有量化指标**。定位次数、延迟、精度、帧率，PPT 里有和 MCU 或纯软件的对比数据。
4. **纯 PS 软件实现直接扣分**。安路 2026 评分表白纸黑字写了。
5. **系统完整度和现场演示效果是硬门槛**。知乎经验帖总结的优秀作品特征：工业级应用、系统完整、演示效果好、答辩 PPT 精致、有量化对比。
6. **命题基础题也能拿一等奖，但要做到极高完成度**。开放题竞争最"卷"，硬题参赛人少、实现核心功能即可获奖。
7. **获奖作品几乎都能用一句话讲清"给谁用、解决什么"**。鸟声识别、话语者聚焦、脑电癫痫检测、眼动追踪都是先有具体的人和痛点，FPGA 只是让它第一次变得可能。工业题不吃亏，但很难拿最佳创意奖，且容易和命题赛道的大量作品撞车。

---

## 5. "MCU 难以实现"的判据

答辩时建议做一页对比表，逐条写出 MCU 版本做不到的数字。一个题目至少要占下面一条：

| 维度 | FPGA 能做到 | MCU 的极限 |
|---|---|---|
| 采样率 | 数十 MSPS 到 GSPS，多通道相位相干到纳秒级 | 单通道 1 到 5 MSPS，多通道无法严格同步 |
| 像素吞吐 | 每秒 100 M 像素以上的全流水线处理 | 几 M 像素每秒，且要占满 CPU |
| 闭环延迟 | 控制环 100 µs 以内，视觉"帧到动作"2 ms 以内 | 控制环 50 到 100 µs 需要独占 CPU，视觉闭环通常 30 ms 以上 |
| 独立时序通道 | 64 到 256 路独立精确相位的输出 | 定时器通道通常不足 32 路，相位精度受中断抖动影响 |
| 高速接口 | MIPI、HDMI、SerDes、10G 以太网、JESD204B | 只能靠外置桥接芯片 |

---

## 6. 选题建议（场景优先版）

### 6.0 筛选方法

每个候选按三个维度评估：

- **撞车风险**：在嵌赛、集创赛、研电赛、电赛的公开获奖作品和开源项目中检索同类作品。
- **FPGA 必要性**：MCU 方案的物理极限与本方案指标之间的差距，必须有数字。
- **技术深度**：能否分成基础层、架构层、创新层三层来讲，每层都有 FPGA 逻辑设计的实质内容。

叙事统一用一个模板：谁，在什么情况下，现在为什么做不到，FPGA 让它第一次可能，评委现场看到什么。

撞车检索结果：

| 候选 | 检索到的同类作品 | 撞车风险 | 结论 |
|---|---|---|---|
| 蝙蝠超声声学监测 | 无任何学生竞赛作品。可听声域有西交声学相机（2025 AMD 赛道）、集创赛 2021 声源定位；开源有树莓派方案 BatDetect2、acoupi | 低 | 保留，首推 |
| 超声相控阵空中触觉 | 嵌赛、集创赛、研电赛均未见。物理实验设计大赛有 STM32+FPGA 50 通道悬浮装置；开源有 SonicSurface、Zynq 悬浮平台 | 低 | 保留，必须超越开源方案 |
| 乒乓球落点与擦边判罚 | 无 FPGA 竞赛作品。仅有 Basys3 HSV 追球教程、LED 乒乓球游戏机课设、上海理工乒乓球机器人（PC 方案） | 低 | 保留 |
| 高速追光斑视觉伺服 | 2023 电赛 E 题 OpenMV 加舵机追激光点方案泛滥 | 中 | 降为扩展模块 |
| 水下可见光通信 | 2023 研电赛东北赛区一等奖，大连理工，FPGA 实现 30 Mbps OOK 与 16QAM，12 m 水下传输 | 高 | 淘汰 |
| 结构光脊柱侧弯筛查 | 东南大学 PYNQ 三维医学重建（2024 国一）、FPGA 异构三维测量专利、芙索特商用产品 | 中 | 淘汰，FPGA 必要性弱 |

---

### 6.1 首推：城市蝙蝠声学夜巡仪

**故事**。蝙蝠约占哺乳动物种类的五分之一，是城市生态健康的指示物种，但人耳听不到，普通麦克风录不到。生态调查依赖进口蝙蝠探测器，单台数万元，而且只能录音回去分析，不能现场识别。一台低成本设备在夜间自动检测蝙蝠叫声、判断类型和代表物种、指出飞来方向、记录整晚活动曲线，给保护区、校园和城市公园使用。

**撞车与差异化**。2025 年最佳创意奖是武汉大学的鸟类声音识别系统，评委已经认可"生物多样性监测"这个场景。蝙蝠站在同一条延长线上，但技术难度高一个量级：鸟声在 1 到 10 kHz，任何 MCU 都能采；蝙蝠在 40 到 90 kHz，需要 MHz 级 PDM 数据流。检索未见任何学生竞赛作品。

**FPGA 必要性**：

| 指标 | 本方案 | MCU 极限 |
|---|---|---|
| 采集 | 8 路超声 PDM 麦克风，4.8 MHz 时钟同步，抽取到 384 kHz PCM | STM32 的 DFSDM 外设可接 8 路，但 8 路 4.8 MHz 抽取已占满，无余力做后续处理 |
| 实时频谱 | 8 路连续 STFT 流水线，HDMI 输出瀑布图 | 单路 STFT 已是极限 |
| 定位 | 多通道 GCC-PHAT 互相关或延迟求和波束成形，方位刷新不低于 100 Hz | 无余力 |
| 时间分辨 | 叫声持续 1 到 50 ms，CF/FM 结构需亚毫秒级特征提取 | 受中断抖动影响 |

中国常见蝙蝠主频参考：东亚伏翼约 48 kHz，鼠耳蝠属 40 到 51 kHz，菊头蝠 57 到 58 kHz，大蹄蝠 69 到 74 kHz，中蹄蝠 85 到 92 kHz。麦克风选用 SPH0641LU4H 一类超声 PDM MEMS，带宽到 80 kHz，超声模式时钟 4.8 MHz。

**技术深度三层**：

- 基础层：PDM 接口、多级 CIC 抽取加补偿 FIR、STFT 流水线、HDMI 瀑布图显示。
- 架构层：8 通道同步采集，板内 FFT 到 IFFT 的 GCC-PHAT 互相关得到方位角，叫声触发检测（能量加频带判据）并把原始数据写入 SD 卡。
- 创新层：CF 型与 FM 型判别，主频、带宽、时长特征提取，用决策树或小型 CNN 做代表物种分类；多次叫声的方位串成飞行轨迹叠加在画面上，形成"蝙蝠雷达"效果；整晚活动曲线统计。

**演示脚本**。现场用另一块板加宽带压电换能器播放公开蝙蝠叫声数据集，屏幕实时显示瀑布图、类型、代表种名、方位和轨迹。移动播放器，方位随之变化。再放一段真实夜间外场录像作为佐证。

**赛题挂靠与硬件**。安路自主命题（选题五），推荐 HX1P35A（38K LUT、40 DSP），或 DR1 做 PL 采集定位加 PS 分类界面的异构方案；也可走 AMD 自主命题。硬件为 8 只超声 PDM 麦克风（单价几十元）、自制阵列板、HDMI 屏、SD 卡、演示用压电换能器。总成本几百元。

**风险与提醒**：

- 现场没有真蝙蝠，演示依赖播放器。普通 40 kHz 换能器带宽窄，必须用宽带压电片或 MEMS 超声扬声器，9 月内要验证能覆盖 40 到 90 kHz。
- 中国本土种的公开标注数据较少。答辩定位为"类型识别加若干代表种"，不要宣称全物种识别。
- 8 路同步的 PDM 时钟走线要等长，阵列板布局要提前做。

---

### 6.2 备选一：空中触觉图形显示器（面向视障人群）

**故事**。视障人士无法感知屏幕上的图形，盲文点显器只能显示文字，触觉图形显示器价格数万元。用 256 路超声相控阵在空中聚焦出可触摸的点，再让焦点沿轨迹高速扫描，手伸过去就能摸到圆、方、折线、地图轮廓。

**撞车与差异化**。嵌赛、集创赛、研电赛均未检索到。开源方案 SonicSurface 和 Zynq 悬浮平台存在，但它们的 FPGA 只负责接收 PC 算好的相位并输出，或只做单焦点。本方案的差异化必须体现在三点：相位求解器在 FPGA 内、更新率提升两个数量级、多焦点与闭环。

**FPGA 必要性**。这是四个候选中数据最硬的一张表：

| 指标 | Arduino Mega 方案 Ultraino | 商用 Ultraleap | 本方案 FPGA |
|---|---|---|---|
| 通道数 | 64 | 256 | 256 |
| 相位分辨率 | π/5，每周期 10 级 | 未公开 | 每周期 64 级以上 |
| 焦点更新率 | 低于 100 Hz | 16 kHz | 不低于 1 kHz，目标 10 kHz |
| 时空调制触觉 | 不可行 | 可行 | 可行 |

文献结论：时空调制触觉需要 1 到 20 kHz 的焦点更新率，皮肤机械感受器最敏感区在 200 Hz 附近，Arduino 方案差两个数量级。

**技术深度三层**：

- 基础层：256 路 40 kHz 方波相位发生器（计数器加相位寄存器），移位寄存器或直接 IO 驱动，单焦点悬浮泡沫小球。
- 架构层：焦点坐标到 256 路相位的板内实时求解（距离计算加相位查表，流水线可超过 10 kHz），时空调制沿轨迹扫描焦点画出形状，幅度控制。
- 创新层：多焦点（板内简化 GS 迭代或 IBP 算法），红外测距或摄像头感知手的位置做闭环，把简单 SVG 图形转成触觉路径，双阵列对置做三维悬浮轨迹。

**演示脚本**。评委伸手在阵列上方 15 到 20 cm 处感受形状，按键切换圆、方、三角、箭头，屏幕同步显示当前形状。保底演示是悬浮小球沿轨迹移动，视觉冲击最强。

**赛题挂靠与硬件**。安路自主命题；紫光同创自主命题"音视频"领域；AMD 自主命题。硬件为 256 只 40 kHz 换能器（MA40S4S 或国产同款）、MOSFET 或缓冲器驱动板、24 V 电源。FPGA IO 需要 64 路以上配合移位寄存器，或直接 256 路。

**风险与提醒**：

- 256 只换能器的焊装和极性标定工作量大。建议 9 月先做 8×8 验证，10 月扩到 16×16。
- 触觉强度有限，视障场景的用户验证短期做不了，答辩定位为"原型验证"。
- 20 Vpp 连续驱动发热明显，电源和散热要留余量。

---

### 6.3 备选二：乒乓球落点与擦边电子裁判

**故事**。2026 年海口亚洲杯女单决赛因为没有鹰眼系统，一个擦边球争议引发全网讨论。国际乒联的 TTR 回放系统需要 8 到 10 台高速相机和多台电脑，业余赛事和校园比赛用不起。用两台低成本全局快门相机加一片 FPGA，在球台旁实时给出落点、界内外和擦边置信度。

**撞车与差异化**。无 FPGA 竞赛作品。上海理工乒乓球机器人（双目识别耗时不足 1 ms）是最接近的工程参考，但那是 PC 方案。学术界 Jetson Nano 落点检测只有 45 fps。2023 电赛 E 题的 OpenMV 追激光点是 MCU 视觉的典型代表，正好用作对比基线。

**FPGA 必要性**：

| 指标 | 数值 |
|---|---|
| 球速 | 扣杀 20 到 30 m/s，纪录约 47 m/s |
| 触台时间 | 约 1 ms 量级 |
| 30 fps 相机帧间球移动 | 0.7 到 1 m，落点只能猜 |
| OV9281 640×400 全幅 260 fps 帧间移动 | 8 到 12 cm |
| OV9281 ROI 模式约 500 fps 帧间移动 | 4 到 6 cm |
| 双相机同步 | FPGA 同一时钟触发，同步误差小于 1 µs；两台 MCU 相机做不到 |

落点由触台前后帧的抛物线拐点拟合得到，帧率越高拐点越准。MCU 视觉方案在 QQVGA 下只有几十 fps，连球都拍不成清晰的点。

**技术深度三层**：

- 基础层：双 MIPI 相机采集（PH1P35 有两个 D-PHY 硬核正好够用），ROI 高帧率配置，硬件同步曝光，流水线阈值、连通域、质心。
- 架构层：双目三角测量在板内完成，帧间轨迹缓存与抛物线拟合，触台事件检测（垂直速度反向），落点映射到球台坐标系。
- 创新层：擦边判定输出落点距边线的置信区间，球速与旋转估计，HDMI 实时叠加轨迹与争议球慢回放，加一路麦克风用擦边声与正常声的频谱差异做特征融合。

**演示脚本**。现场用缩比球台，发球机或人工抛球，屏幕实时显示落点、界内外、球速；争议球自动慢回放。

**赛题挂靠与硬件**。安路 2026 选题二（MIPI 实时图像处理，进阶项"动态目标跟踪与坐标叠加"和"处理延迟可视化"直接对应）；AMD 自主命题。硬件为 HX1P35A 或 Zynq MIPI 板、OV9281 模组 2 只、镜头、补光灯、缩比球台。

**风险与提醒**：

- 真正毫米级擦边判罚需要 1000 fps 以上，OV9281 做不到。答辩定位为"落点与界内外判定加擦边置信度"，不要宣称替代 TTR。
- 高帧率 ROI 寄存器配置要向模组厂商索取文档，9 月内必须跑通。
- 双相机标定要提前用 MATLAB 或 OpenCV 完成，参数固化进 FPGA。

---

### 6.4 加分模块

- 高速视觉伺服：在乒乓球方案上加二维云台跟随球或激光标记落点，体现"帧到动作"低于 2 ms。
- 多板亚微秒同步：蝙蝠方案的多站定位，或触觉方案的多阵列拼接。安路指南明确鼓励多板主从结构。
- 进位链 TDC：几十皮秒级时间测量，可用于蝙蝠方案的到达时间差精化。

---

### 6.5 三个方案对比与选择建议

| 维度 | 蝙蝠夜巡仪 | 空中触觉显示 | 乒乓球电子裁判 |
|---|---|---|---|
| 撞车风险 | 最低 | 低 | 低 |
| FPGA 必要性论证 | 强 | 最强，有文献数字 | 强，需诚实说明帧率上限 |
| 最佳创意奖潜力 | 高，鸟声识别延长线 | 最高 | 中高 |
| 硬件成本 | 最低，几百元 | 中，千元级 | 中 |
| 硬件工程风险 | 低 | 高，焊装 256 只换能器 | 中，MIPI 高帧率配置 |
| 算法风险 | 中，分类数据有限 | 低，单焦点很成熟 | 中，标定与拟合 |
| 现场演示可控性 | 依赖播放器 | 最可控 | 需要场地 |
| 适合团队 | 信号处理基础好 | 动手能力强 | 图像处理基础好 |

选择建议：

- 团队里有人能焊 PCB 和阵列，选空中触觉，冲最佳创意奖。
- 团队偏信号处理和 FPGA 逻辑，选蝙蝠夜巡仪，综合风险最低且场景新。
- 团队做过 MIPI 和图像流水线，选乒乓球裁判。

综合权衡后首推蝙蝠夜巡仪，因为它同时满足零撞车、评委已认可的场景方向、硬件风险最低三个条件。

---

## 7. 不建议的方向

| 方向 | 原因 |
|---|---|
| 以太网传图、UDP 视频回传 | 安路命题基础题，去年大量三等奖来自这里 |
| 通用示波器、频谱仪 | 高云和紫光的仪器赛题已成红海，除非指标远超同类 |
| 单纯移植 YOLO 加速器 | 每年数量最多，海洋大学导盲 YOLO 只拿三等奖 |
| RISC-V 软核平台 | 2020 年已拿过一等奖，现在缺新意 |
| 只用 PYNQ 的 ARM 端跑算法 | 经验帖明确提醒重点是 FPGA 逻辑设计 |
| 水下可见光通信 | 2023 研电赛东北赛区一等奖已做到 30 Mbps、12 m 水下，本科队两个月难以超越 |
| 结构光脊柱侧弯筛查 | 静态扫描用 PC 也能做，FPGA 必要性弱；东南大学已有三维重建国一，且有商用产品 |
| 追激光光斑云台 | 2023 电赛 E 题方案泛滥，评委已看腻 |

## 8. 时间规划

| 阶段 | 时间 | 目标 |
|---|---|---|
| 定题与报名 | 09-04 至 09-22 | 确定平台和赛题挂靠，官网报名，提交板卡申请表 |
| 链路打通 | 09-22 至 09-30 | 传感器采集和输出链路跑通，确认关键指标可达 |
| 核心流水线 | 10-01 至 10-20 | 完成核心算法硬件化，跑通闭环 |
| 量化测试 | 10-21 至 10-31 | 延迟、精度、帧率测试，做与 MCU 或软件的对比表 |
| 文档与视频 | 11-01 至 11-04 | 报告、RTL 说明、10 分钟演示视频，11-04 18:00 前提交 |
| 决赛准备 | 11-05 至 11-19 | 追加扩展功能，准备现场演示和基础能力考核 |

---

## 9. 参考资料

- Sipeed Tang Mega 60K 官方说明（2026-09-24 核对）：https://wiki.sipeed.com/hardware/zh/tang/tang-mega-60k/mega-60k.html
- Sipeed Tang Mega 60K 官方示例（2026-09-24 核对）：https://github.com/sipeed/TangMega-60K-example
- Zynq 相控阵论文 v2（包含板内相位计算加速，2026-09-24 核对）：https://arxiv.org/html/1901.07317v2

- 2026 年 FPGA 赛道选题指南（安路）：https://www.anlogic.com/support/university/competitions/eda/news1/42.html
- 2026 年 FPGA 创新设计竞赛通知（北航教务部转发）：https://jiaowu.buaa.edu.cn/info/1016/9028.htm
- 2025 年紫光同创选题指南 PDF：https://oss.fpgachina.cn/file/cacheFile/2025-6-27/5f7674763cf64e2c97b9a0e55d857b88.pdf
- 2025 年安路选题指南 PDF：https://oss.fpgachina.cn/file/ueditor/image/20250901/ca5b46ed50144e63b43a5b890e95cfb2.pdf
- 2025 年紫光同创赛题发布（电子发烧友）：https://www.elecfans.com/d/6888716.html
- 2024 年高云选题指南 PDF：https://oss.fpgachina.cn/file/cacheFile/2024-9-4/bba107c3138c495e881a08ba28e745c3.pdf
- 奥唯思独家支持 2025 易灵思赛道：https://www.szovs.com/en/new-product-release/559676
- 安路科技 2025 年竞赛回顾：https://www.anlogic.com/news/company-news/188.html
- AMD 助力全国大学生 FPGA 创新设计竞赛：https://fpga.eetrend.com/content/2025/100588333.html
- 武汉大学第四届 3 项一等奖：https://uc.whu.edu.cn/info/1121/10579.htm
- 南京大学 2024 连夺两杯：https://ndbgs.nju.edu.cn/xydt/20241204/i304062.html
- 南京大学 2025 再创佳绩：https://www.nju.edu.cn/info/3341/450721.htm
- 江南大学高云脑电分析设备一等奖：https://www.jiangnan.edu.cn/info/1401/12936.htm
- 天津工业大学易灵思眼动追踪：https://www.tiangong.edu.cn/2024/1205/c634a100194/pagem.htm
- 东南大学 2024 一等奖：https://news.seu.edu.cn/2024/1226/c5495a515849/page.htm
- 苏州大学 2024 一等奖：https://dzxx.suda.edu.cn/54/13/c8245a611347/page.htm
- 中国石油大学（华东）2025 获奖：https://ocean.upc.edu.cn/2025/1215/c15097a479949/page.htm
- 南邮 2025 一等奖 8 项：https://deei.njupt.edu.cn/2025/1202/c6882a293000/page.psp
- Ultra-Vision 国一加易灵思杯开源仓库：https://github.com/Floatkyun/Ultra-Vision
- 2023 高云赛道多路网络视频监控开源仓库：https://github.com/BigPig-Bro/udp_gmii_ov5640
- 2025 高云赛道国一作品视频：https://www.bilibili.com/video/BV15rKP6pEwi/
- 2024 年决赛成绩公示 PDF：https://oss.fpgachina.cn/file/ueditor/image/20241202/b945ac8eb432463cbb874c9bf81f3524.pdf
- 2022 年 FPGA 创新设计竞赛选题分析与建议：https://blog.csdn.net/l5200566/article/details/126696713
- 全国大学生嵌入式与系统设计竞赛经验分享（知乎）：https://zhuanlan.zhihu.com/p/476894504
- FPGA 创新设计赛道官网：http://www.fpgachina.cn/

- Ultraino 开源相控阵论文（Arduino 方案的相位分辨率与更新率限制）：https://www.researchgate.net/publication/320827817_Ultraino_An_Open_Phased-Array_System_for_Narrowband_Airborne_Ultrasound_Transmission
- SonicSurface 开源超声相控阵：https://github.com/upnalab/SonicSurface
- 基于 Zynq 的 FPGA 声悬浮平台，更新率 16.6 kHz：https://arxiv.org/html/1901.07317
- GS-PAT 多焦点求解器与 10 kHz 驱动板：https://dl.acm.org/doi/abs/10.1145/3386569.3392492
- 空中触觉采样策略与更新率要求：https://dl.acm.org/ft_gateway.cfm?id=3300351&type=pdf
- 基于超声波相控阵的触觉反馈技术（DSP+FPGA 双核）：https://www.fx361.com/page/2021/0809/8717988.shtml
- 可控超声悬浮装置（物理实验设计大赛）：https://blog.csdn.net/xiaoxuesheng2018/article/details/130836736
- 六种共栖蝙蝠的回声定位信号比较（主频数据）：https://www.mammal.cn/CN/abstract/abstract2390.shtml
- 蝙蝠声音信号功能研究进展：https://html.rhhz.net/scdwzz/html/58206.htm
- 三维麦克风阵列跟踪回声定位蝙蝠：https://zhuanlan.zhihu.com/p/1952389547615851423
- SPH0641LU4H 超声 PDM 麦克风：https://www.digikey.com/en/products/detail/syntiant/SPH0641LU4H-1/5332438
- HiRIS 1024 通道超声麦克风阵列（FPGA PDM 采集参考）：https://arxiv.org/html/2402.13110v1
- BatDetect2 开源蝙蝠叫声检测器：https://github.com/macaodha/batdetect2
- 基于麦克风阵列声源定位系统的 FPGA 实现：https://www.chinaaet.com/article/116413
- OV9281 官方规格（1280×800 120 fps，VGA 180 fps）：https://www.ovt.com/products/ov9281/
- OV9281 在树莓派上的实测帧率（640×400 260 fps）：https://forums.raspberrypi.com/viewtopic.php?t=340880
- 安路 PH1P 系列（2 个 MIPI D-PHY v2.0 硬核，2.5 Gbps）：https://www.anlogic.com/product/fpga/phoenix/ph1p
- 乒乓球 TTR 鹰眼系统说明（人民日报）：http://paper.people.com.cn/rmrb/pc/content/202505/22/content_30074689.html
- 2026 亚洲杯擦边球争议：https://k.sina.com.cn/article_7857201856_1d45362c001905cnr2.html
- 上海理工乒乓球机器人高速双目识别：https://www.usst.edu.cn/_t2/2020/1116/c58a39789/page.psp
- 乒乓球落点检测算法（Jetson Nano 45 fps）：https://www.nature.com/articles/s41598-023-42966-6
- FPGA 乒乓球追踪教程（Basys3）：https://blog.csdn.net/LZY272942518/article/details/46730199
- 2023 电赛 E 题 OpenMV 方案解析：https://cloud.baidu.com/article/3401639
- 2023 研电赛东北赛区一等奖：基于 FPGA 的小型水下无线光通信端机：http://aijishu.com/a/1060000000424446
- FPGA 异构三维测量加速系统专利：https://patents.google.com/patent/CN113720271A/zh

说明：紫光同创、高云、易灵思、AMD 的 2026 版选题指南整理时未能从官网下载中心获取，以上厂商部分基于 2024 或 2025 版整理，请到 fpgachina.cn 下载中心核对最新版本。
