Cody-ic/fpga-air-haptics/desktop_app/docs/baud-options.png

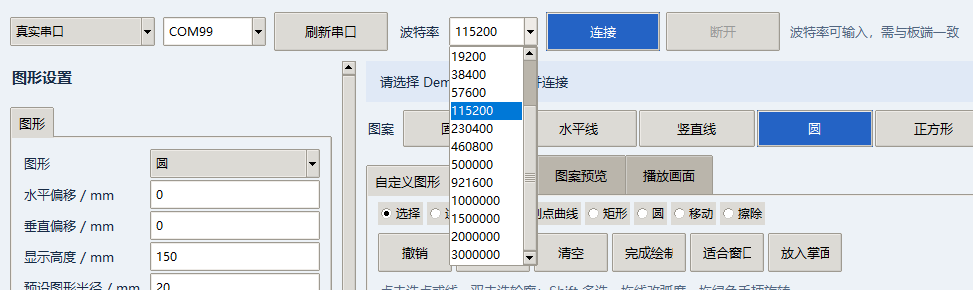
desktop_app/docs/baud-options.png
