Cody-ic/fpga-air-haptics/desktop_app/docs/palm-zoom.png

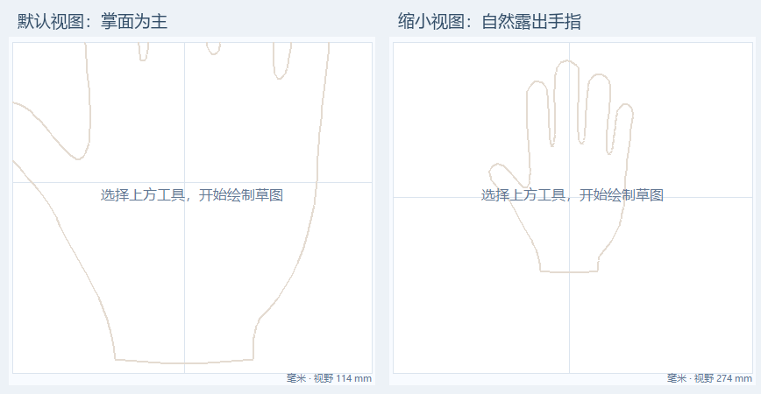
desktop_app/docs/palm-zoom.png
