Cody-ic/fpga-air-haptics/desktop_app/docs/playback.png

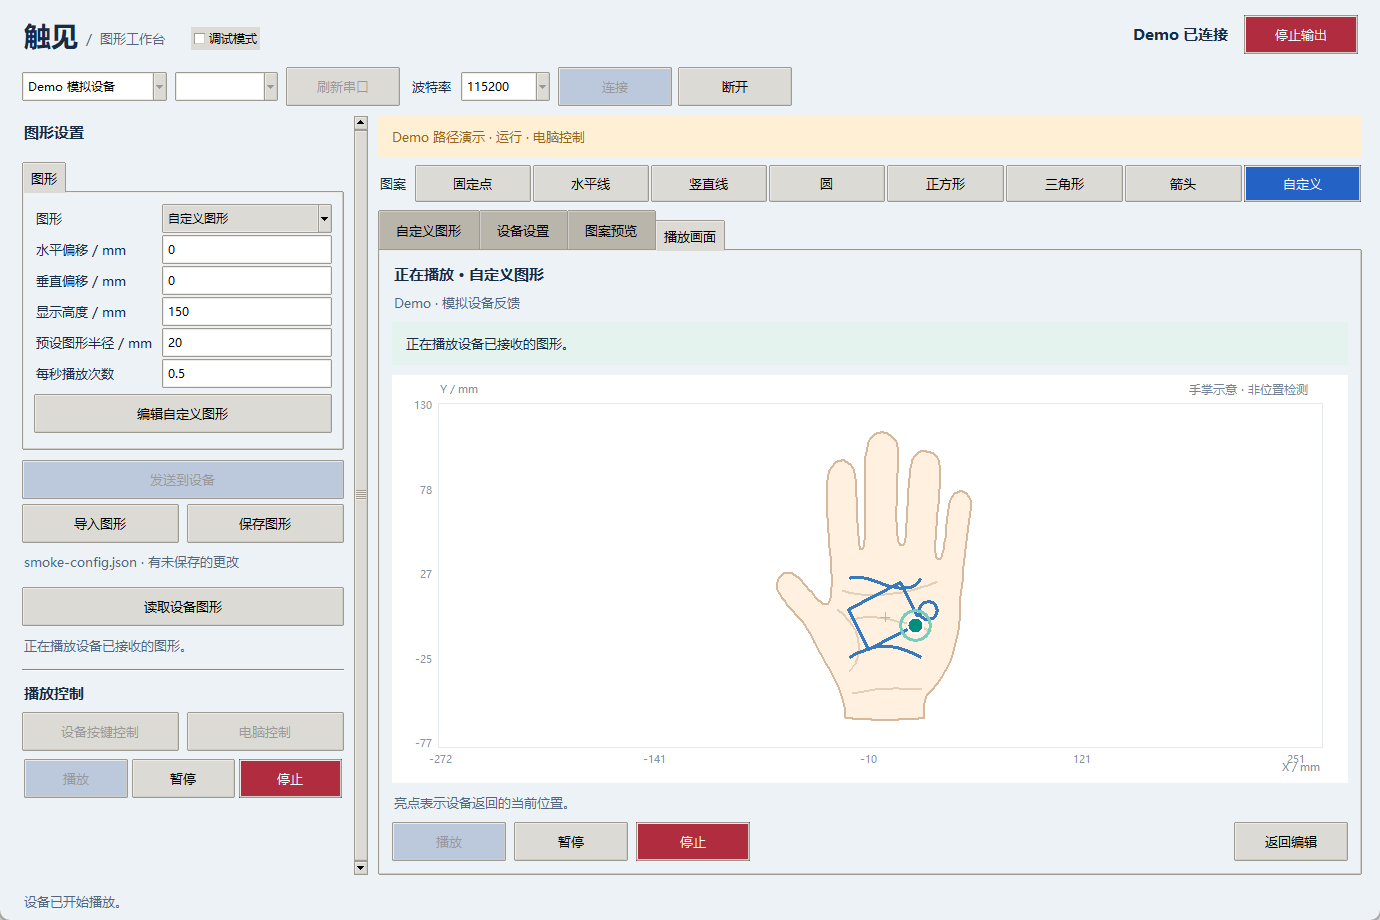
desktop_app/docs/playback.png
