Cody-ic/fpga-air-haptics/desktop_app/docs/presets.png

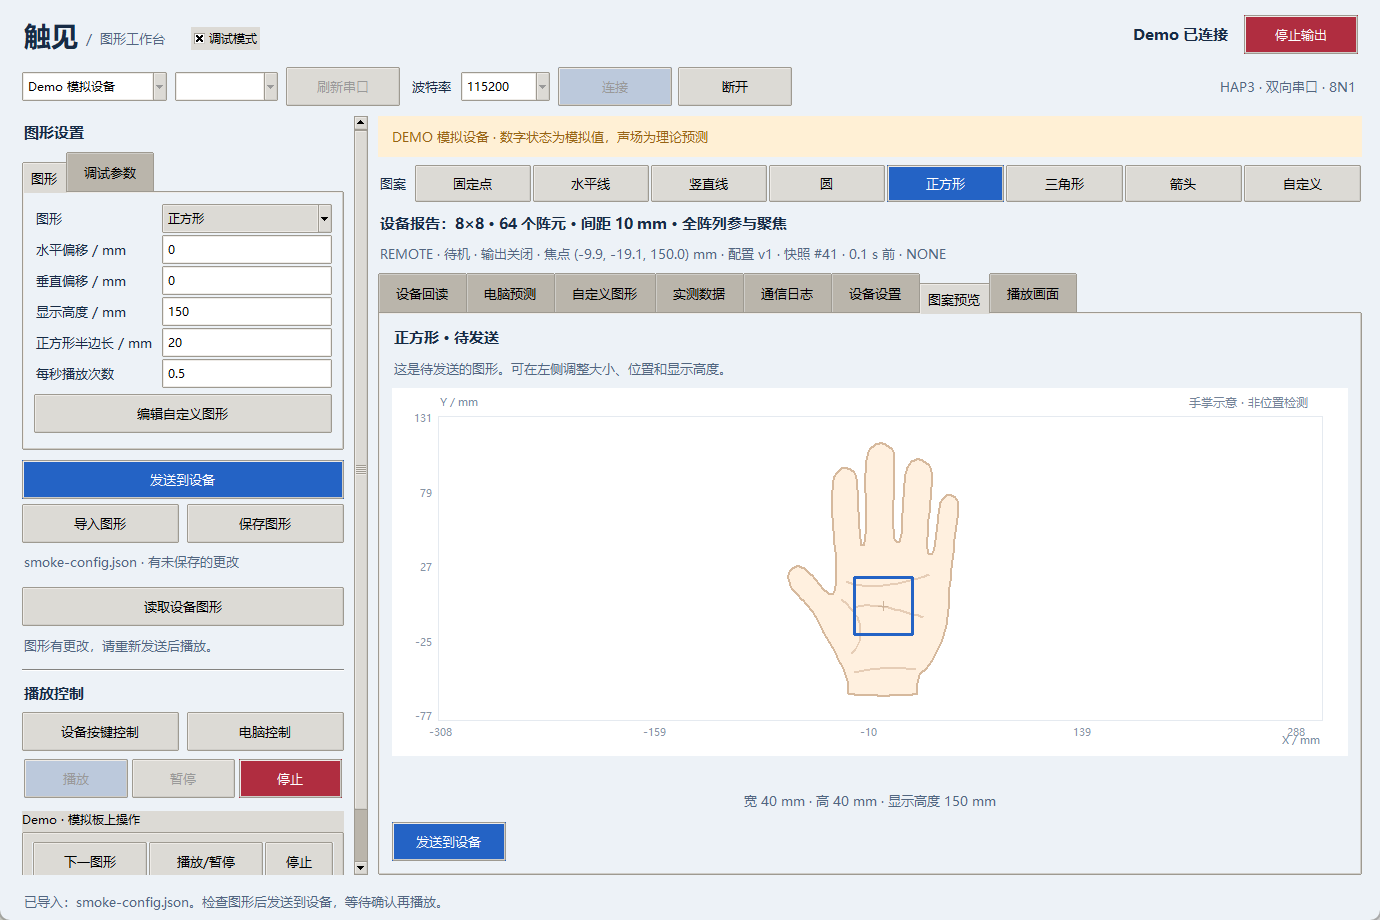
desktop_app/docs/presets.png
