Cody-ic/fpga-air-haptics/desktop_app/docs/sketch-preview.png

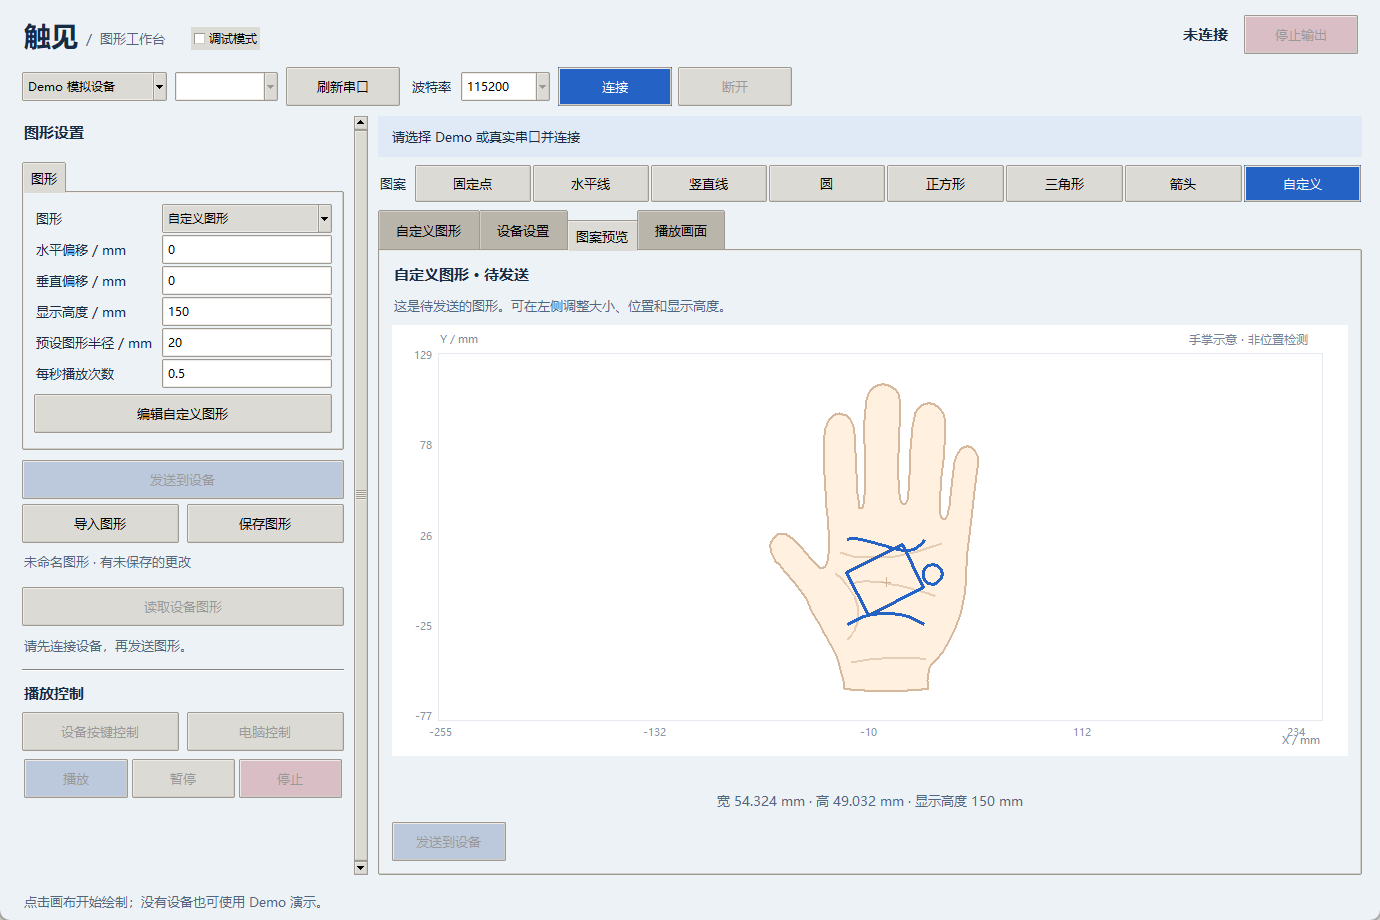
desktop_app/docs/sketch-preview.png
