Cody-ic/fpga-air-haptics/desktop_app/docs/sketch.png

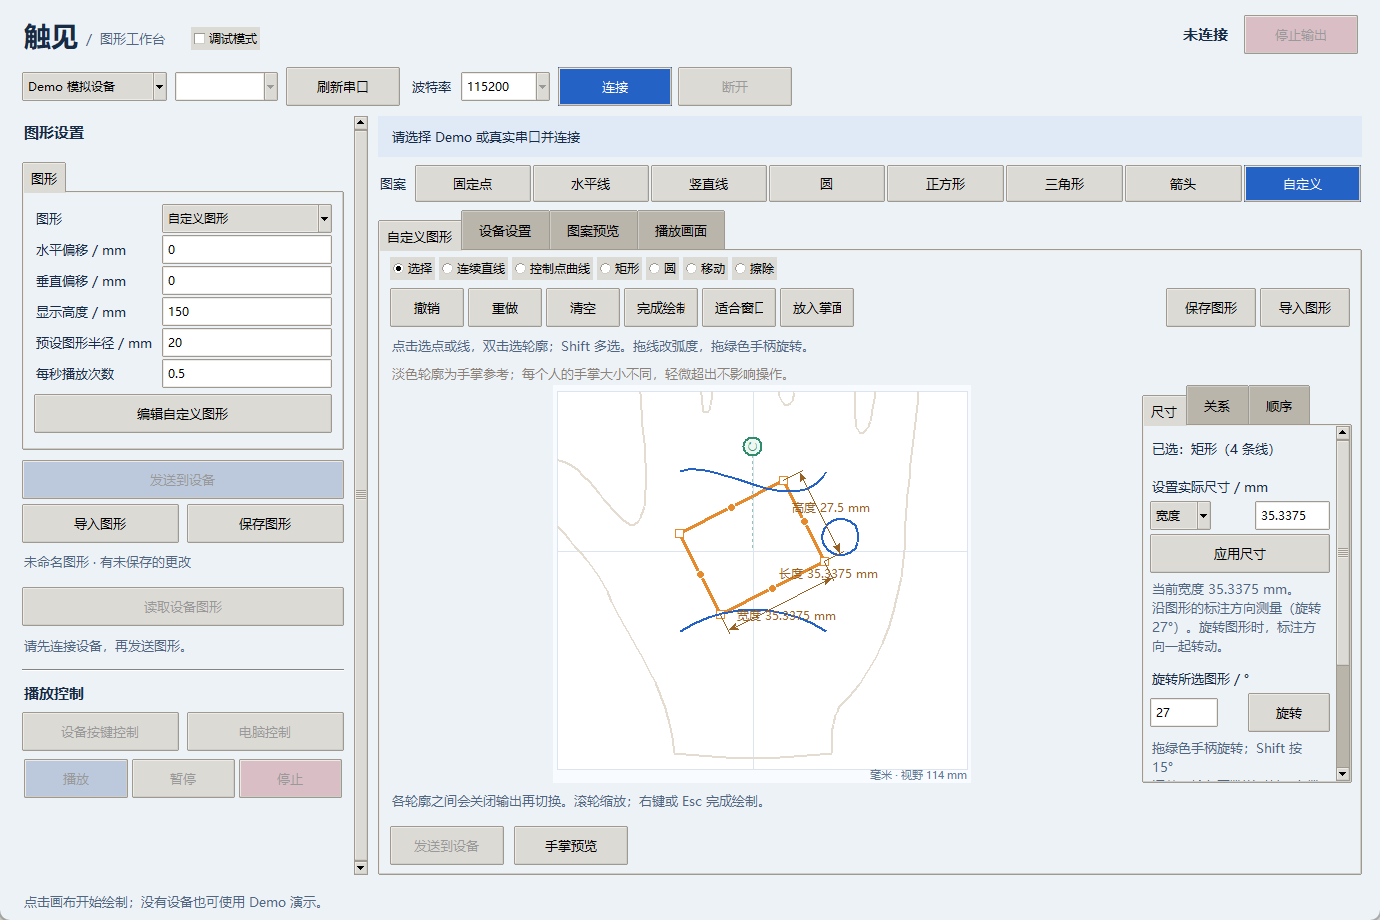
desktop_app/docs/sketch.png
