Cody-ic/fpga-air-haptics/hardware/mechanical/P5_20261015/overhead_8x8_underside.png

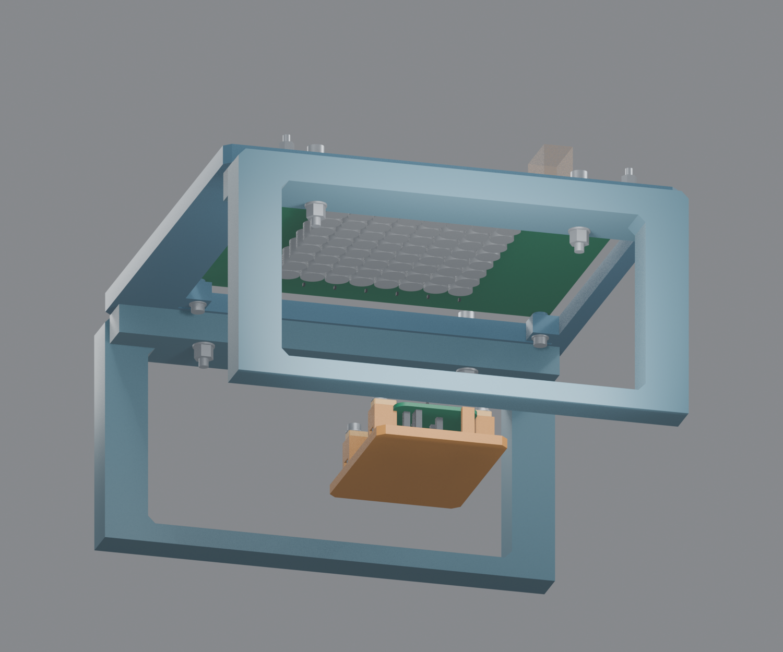
hardware/mechanical/P5_20261015/overhead_8x8_underside.png
