Cody-ic/fpga-air-haptics/hardware/mechanical/P5_20261015/receiver_tray_detail.png

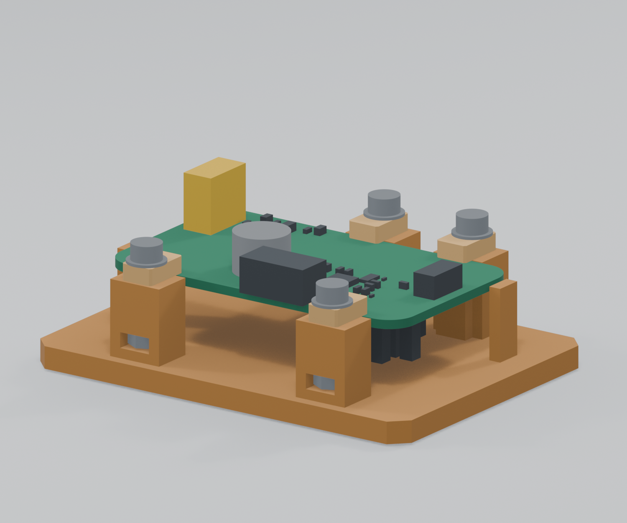
hardware/mechanical/P5_20261015/receiver_tray_detail.png
