Cody-ic/fpga-air-haptics/hardware/mechanical/P5_addons_20261022/film_frame_detail.png

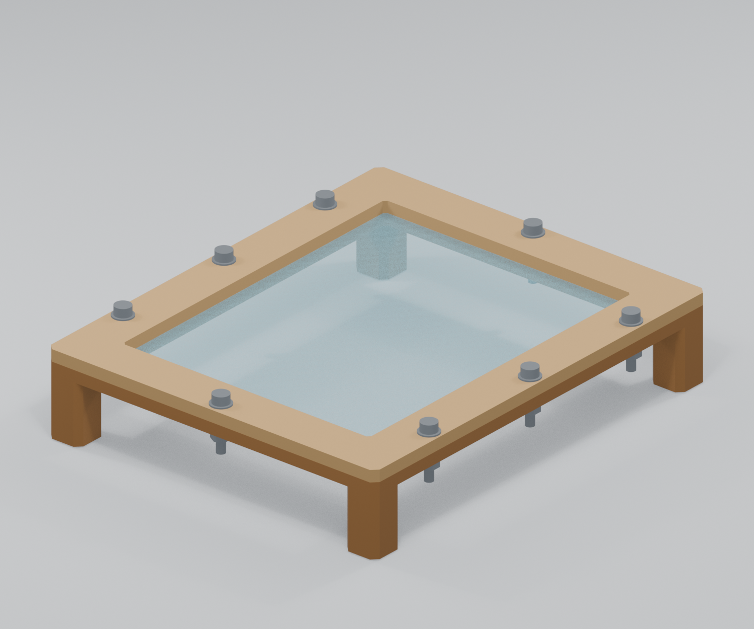
hardware/mechanical/P5_addons_20261022/film_frame_detail.png
