Cody-ic/fpga-air-haptics/hardware/mechanical/P5_addons_20261022/riser_attachment.png

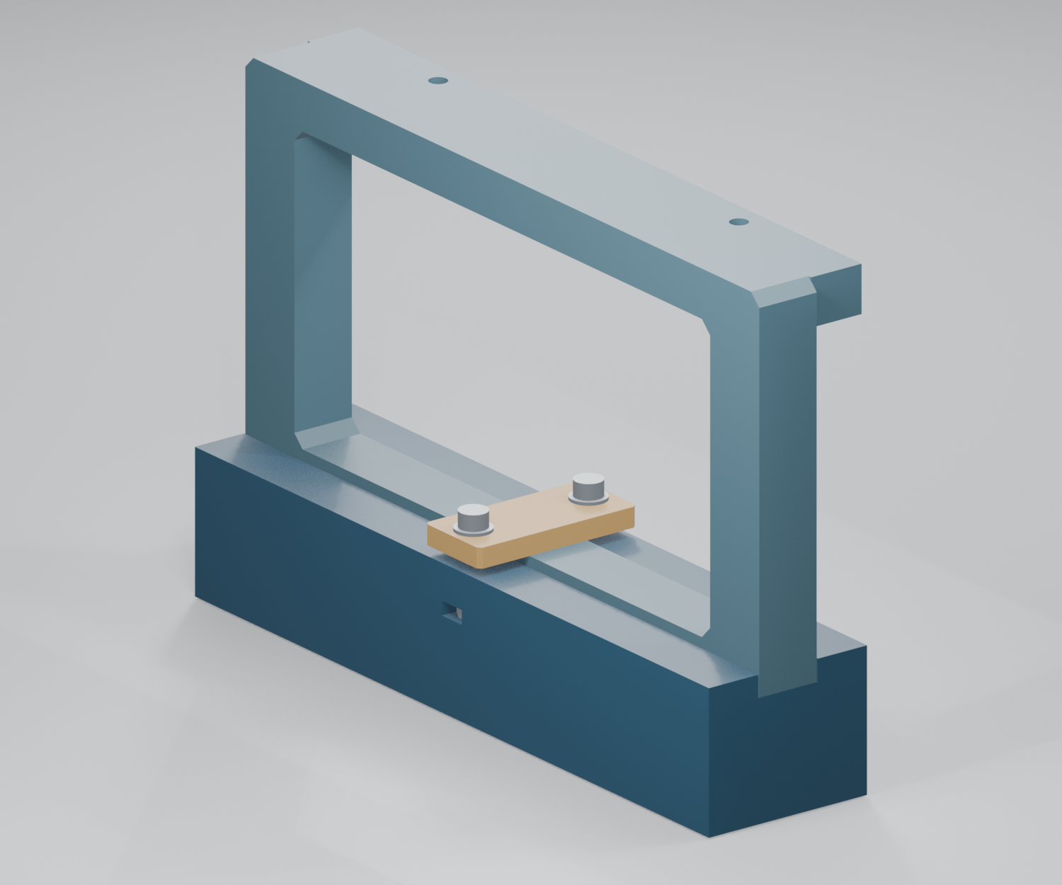
hardware/mechanical/P5_addons_20261022/riser_attachment.png
