Cody-ic/fpga-air-haptics/hardware/mechanical/P5_lifts20_20261025/新增垫子预览.png

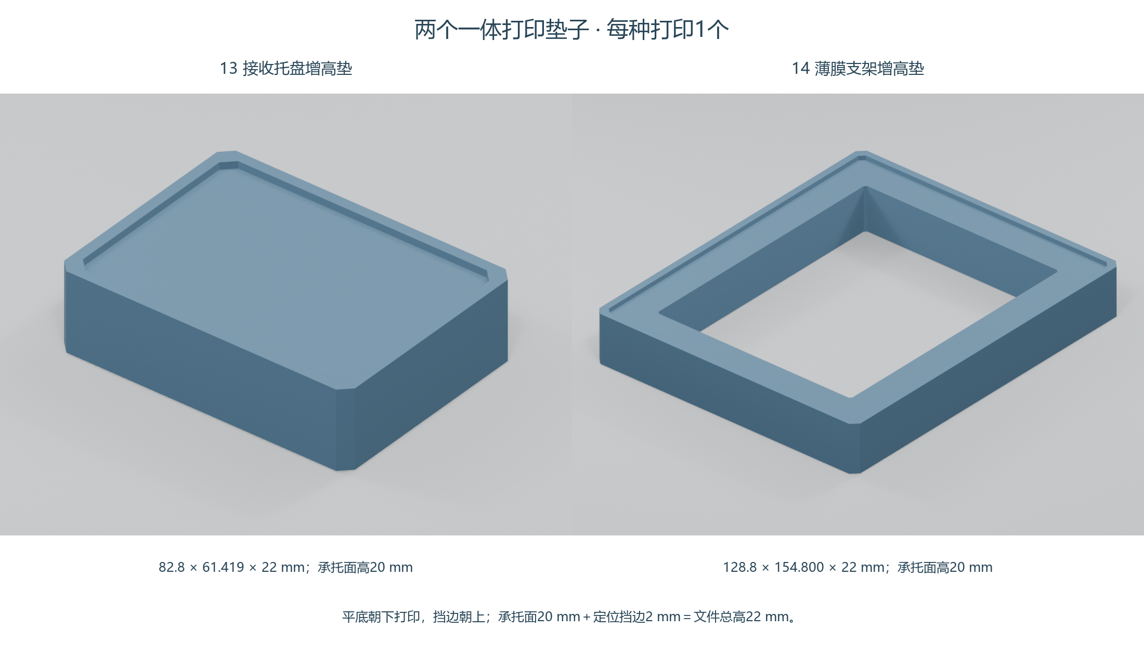
hardware/mechanical/P5_lifts20_20261025/新增垫子预览.png
