Cody-ic/fpga-air-haptics/hardware/mechanical/overhead_setup/装配清单.md

# P5 打印与装配清单

**2026-10-20 学校交付更正：**模型文件种类不等于打印件数。
本次两块发射板各自预装、共用侧架，最终应有 **18 件（含 1 件试片）**；
若上次原包的 7 种模型各打 1 件，现在只补 **侧架 1、套筒 7、压片 3，共 11 件**。
请按[学校打印需求](学校打印需求.md)交付展开后的补打包，每个文件打 1 件即可；
不要将原始 7 文件包继续按一文件一件处理。下面原表保留的是单块发射板配置，套筒为 4 个；
两块板分别预装时需 8 个。

本清单对应2026-10-15的P5固定高度上下布局。两种发射承载框任选一种；左右侧架、接收托盘及紧固件通用。不使用胶水，不在PCB上新增孔。

正式发布目录：`hardware/mechanical/P5_20261015/`。学校打印使用 `TouchSee_Overhead_STL_P5_20261015.zip`；需要源CAD时使用 `TouchSee_Overhead_P5_20261015.zip`。`REF_*_electronics`及参考PCB、元件、螺钉模型只用于装配核对，不属于打印清单。原生与网格核验均已通过，发布包附本版检查记录。

## 打印件

| 零件 | STL | 数量 |
|---|---|---:|
| 共用侧架 | `01_side_trestle.stl` | 2 |
| 4×4发射承载框 | `02_tx_carrier_4x4.stl` | 1，与8×8二选一 |
| 8×8发射承载框 | `03_tx_carrier_8x8.stl` | 1，与4×4二选一 |
| 发射背面绝缘套筒，Ø6×5 | `04_m3_rear_sleeve_6x5.stl` | 4 |
| 独立接收平底托盘 | `05_receiver_flat_tray.stl` | 1 |
| 接收板短压片 | `06_receiver_edge_clip.stl` | 4 |
| 孔径试片，60×18×5 | `07_fastener_fit_coupon.stl` | 1，正式装配不计入 |

单种发射配置共12件正式打印件，另打1件孔径试片。试片四孔为Ø3.4、Ø3.6、Ø4.5、Ø4.7，螺母槽配合在接收托盘上核对。模型包络：承载框182×190×10、侧架188×95.3×30、接收托盘76×54.619×17.6、压片6×9.3×3；精确值和打印方向见发布manifest。先试打试片及托盘，不缩放STL。

## 标准紧固件

| 连接 | 螺钉 | 螺母 | 垫圈/套筒 |
|---|---|---|---|
| 承载框与左右侧架 | M4×30，4颗 | M4尼龙锁紧螺母，4颗 | M4平垫圈，8片 |
| 发射PCB与承载框 | M3×25，4颗 | M3尼龙锁紧螺母，4颗 | M3平垫圈，8片；打印绝缘套筒Ø6×5，4个 |
| 接收PCB短压片 | M3×16，4颗 | **DIN 934普通M3六角螺母，高2.4，4颗** | M3平垫圈，4片 |

合计M3平垫圈12片，M4平垫圈8片。标准螺钉按内六角圆柱头名义包络；发射/侧架锁紧螺母和接收普通螺母分开放置，避免混装。另备少量扎带用于发射架外侧线束卸力，不捆住裸焊点。

若两款发射板希望各自预装承载框，再备一套M3×25四颗、M3锁紧母四颗、M3垫圈八片及Ø6×5套筒四个；侧架的M4连接件可以共用。

## 1. 装发射板

1. 断电，确认使用的是R5 4×4或R2 8×8对应承载框。换能器面向下，装配时垫在承载框边缘，不压换能器网罩。
2. 对准PCB原有四个Ø3.2孔。M3×25从承载框下方穿入，螺钉头与承载框之间放M3平垫圈；由承载框的孔周凸台支撑发射PCB前面。
3. PCB背面每孔先套 **Ø6×5绝缘套筒**，再放Ø7平垫圈和M3尼龙锁紧母。套筒把大垫圈/螺母抬离板面，避免4×4下侧D1/F1附近受压。不得省掉套筒或让Ø7垫圈直接贴该处PCB背面。
4. 对角逐步拧紧到PCB不晃动；若板弯曲、套筒歪斜或压住焊锡，松开检查。保留满线CN1/H1、电解和电源插头的上方/侧面空间。

## 2. 装共用侧架

1. 两侧架底面平放同一桌面，把已装PCB的承载框放上固定台阶，对准四个M4孔。
2. 每孔用M4×30贯穿连接，上下各放一片M4平垫圈，下方拧M4尼龙锁紧母。先全部带上，再对角紧固。
3. 检查四脚落桌、架体不摇晃。发射板背面保持开放，控制线和电源线向侧面引出；架外用扎带卸力，插头附近留松弛量，不靠接头承受线束重量。

## 3. 装接收托盘

1. 将四颗 **普通DIN 934 M3螺母** 从侧面插入托盘螺母槽。槽的名义Z范围为5.8～8.6，高2.8；螺母高2.4。不要硬塞高约4的M3尼龙锁紧母，也不要用薄螺母随意替换。
2. 接收PCB正面朝上放在四块短托台上，底部测试环、元件和焊脚悬空。U4的4pin口位于右侧、XT30位于左侧，SW1位于下侧缺口；三处都不能被台阶或压片夹住。
3. 四片短压片按上下对应方向放置，每片配一颗M3×16和一片M3平垫圈。压片仅接触README标出的2mm板边带，轻拧至无晃动，不压弯PCB。
4. 确认托盘外底面可平贴桌面，板底焊点不接触底板。12mm板底凹腔、8mm测试针伸出均按名义假设建模，若实物超出先调整打印件。
5. 4pin插头和线束上方、右侧同时留空；移动托盘时保留线长，线不得拖起或倾斜接收板。

## 4. 放置与检查

接收托盘与发射架独立放置，不需连接。手动平移托盘，把接收头U1中心对准发射阵列中心参考点；不能用PCB几何中心替代。

名义接收声面Z=24.7，发射声面Z=94.7，相差70。发射离板焊高采用旧10.6、接收采用7.1、PCB厚1.6；真实焊高或打印误差会改变此距离，装好后测量声面外缘确认。不要按压网罩调整高度。

独立STL网格、尺寸、孔位、参考声面间距及接收托盘保守扫掠检查已通过；原生18个零件、2个装配、123张完全定义草图及两配置BREP干涉检查均通过。尚无打印配合、承重或声学实测。最终尺寸、文件和核验状态请与[README](README.md)及发布manifest一并核对。预览中的琥珀色透明区域仅表示50mm假定线束避让区，不是需要打印的罩壳。
