Cody-ic/fpga-air-haptics/hardware/mechanical/P5_lifts20_20261025/step/14_film_stand_lift20.step

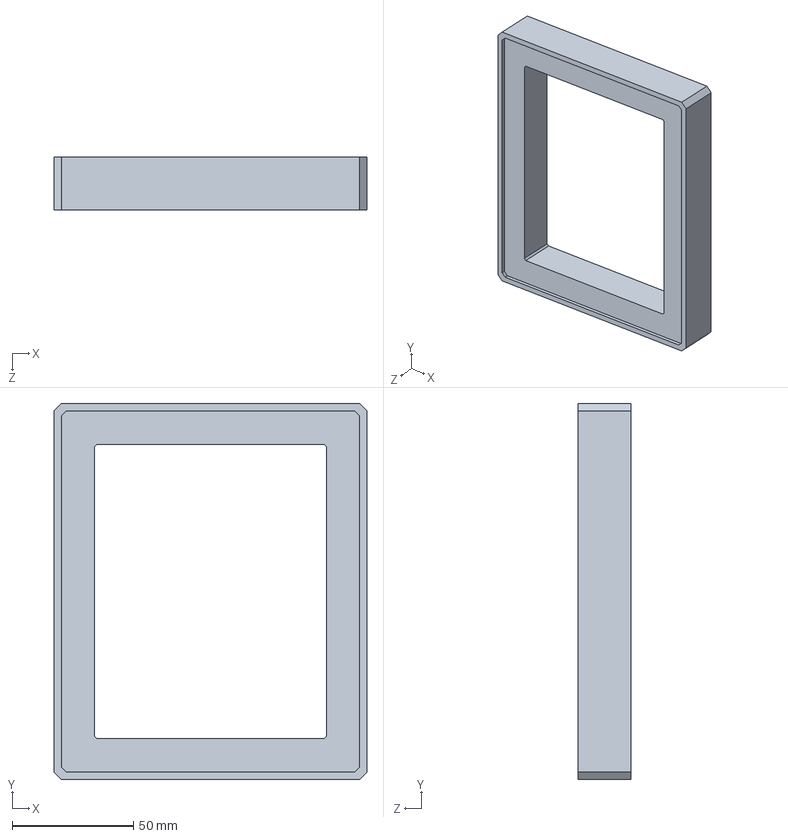
[picture p14: CAD file, 2026-10-25]
hardware/mechanical/P5_lifts20_20261025/step/14_film_stand_lift20.step
128.8 x 154.8 x 22.0 mm
