Cody-ic/fpga-air-haptics/(list of files, cad)

Other CAD files:
hardware/mechanical/P5_lifts20_20261025/stl/14_film_stand_lift20.stl
