Cody-ic/fpga-air-haptics/desktop_app/requirements-build.txt

-r requirements.txt
pyinstaller>=6.16,<7
pillow>=10,<13
