Cody-ic/fpga-air-haptics/hardware/mechanical/P5_lifts20_20261025/垫高装配示意.png

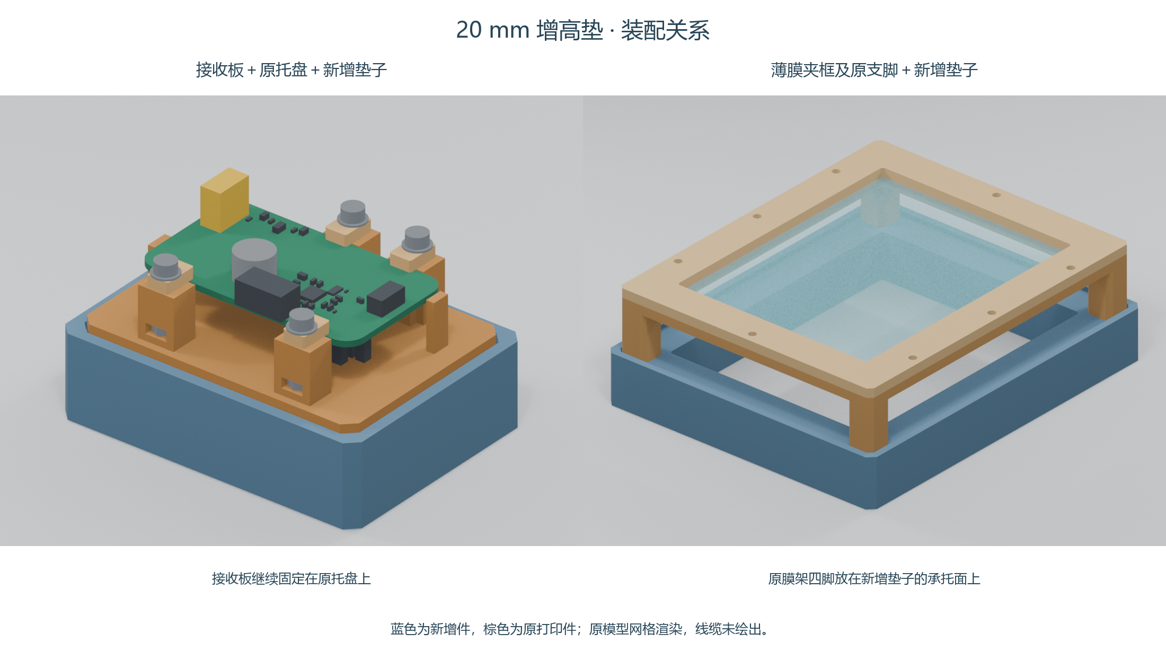
hardware/mechanical/P5_lifts20_20261025/垫高装配示意.png
