Cody-ic/fpga-air-haptics/hardware/mechanical/measurement_coordinates/接收端坐标详图.png

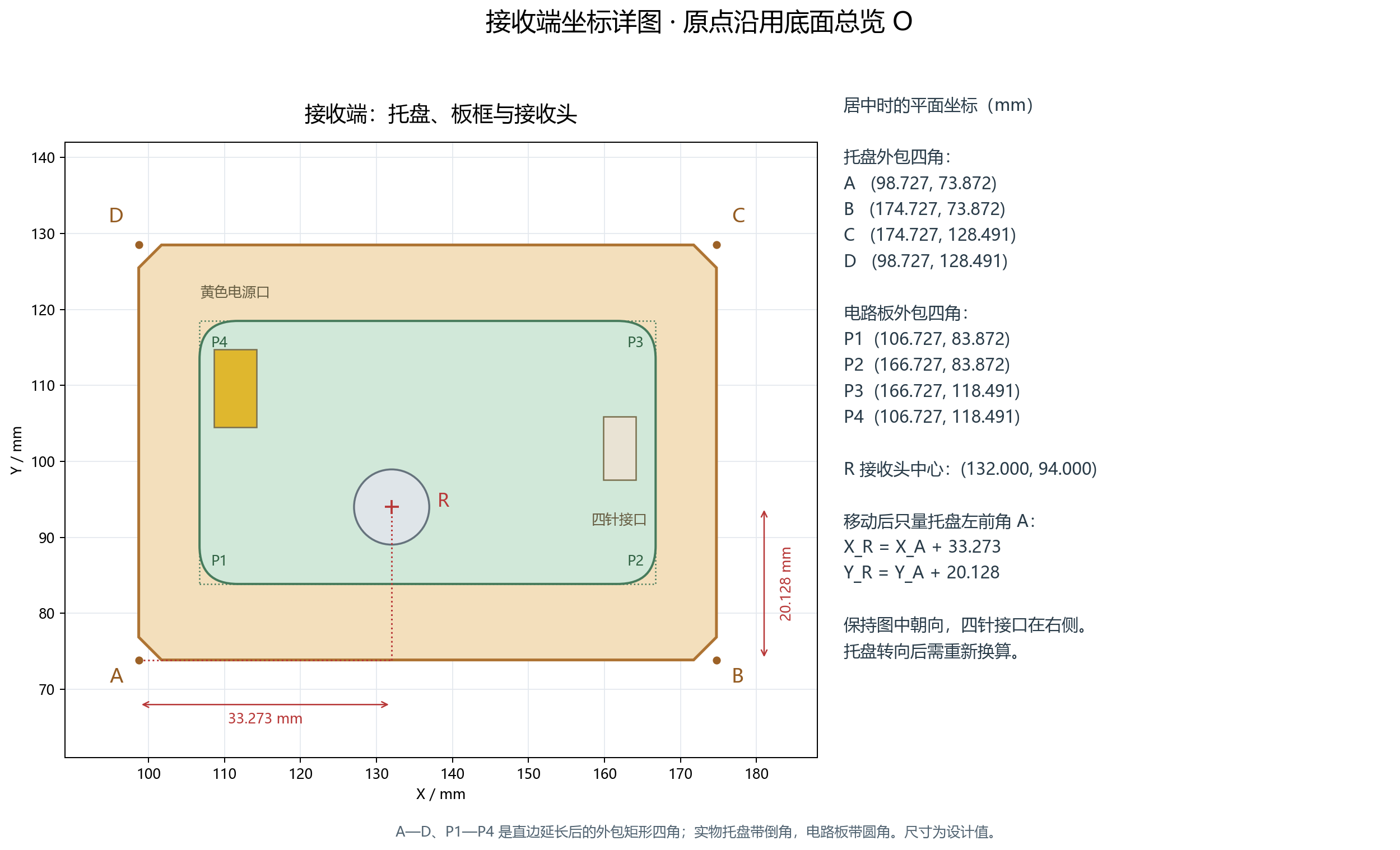
hardware/mechanical/measurement_coordinates/接收端坐标详图.png
