Cody-ic/fpga-air-haptics/(list of files, drawings)

Other design files:
hardware/mechanical/overhead_setup/pcb_contact_regions.json
hardware/mechanical/overhead_setup/pcb_geometry.json
