Cody-ic/fpga-air-haptics/desktop_app/model.py

"""Protocol configuration and a deliberately simplified relative acoustic model.

Coordinates: mm in computation; target coordinates use integer um on the wire.
Legacy arrays use a row-major plane. Explicit arrays retain each channel's XYZ
and normal from the device geometry table (nm / ppm storage units).
Phasor convention: p = sum(exp(j*(k*r + phase))/r). Consequently the
phase code at a target is -k*r modulo 2*pi. The FPGA interprets the code
as a modulo-period waveform delay (acc - offset); its physical emitted
phase has the opposite sign under the exp(+j*w*t) convention.
No calibrated pressure, element directivity, reflections, or haptic threshold.
"""

from dataclasses import asdict, dataclass, field
import math
import re

import numpy as np
from .array_geometry import Geometry, grid_geometry

MAX_SCAN_POINTS = 256
MAX_STROKES = 32

SHAPES = {"POINT": "固定点", "LINE_X": "水平线", "LINE_Y": "竖直线",
          "CIRCLE": "圆", "SQUARE": "正方形", "TRIANGLE": "三角形", "ARROW": "箭头", "CUSTOM": "自定义图形"}
ARRAY_PRESETS = {"4 × 4 · 16 路": (4, 4), "6 × 6 · 36 路": (6, 6),
                 "8 × 8 · 64 路": (8, 8), "12 × 12 · 144 路": (12, 12),
                 "16 × 16 · 256 路": (16, 16), "自定义行列": None}
MAX_PATH_POINTS = 64
MODES = ("LOCAL", "REMOTE")
STATES = ("IDLE", "RUNNING", "PAUSED", "FAULT")


@dataclass(frozen=True)
class ArraySpec:
    """Installed geometry declared by firmware, independent of drawing coordinates."""

    rows: int = 4
    cols: int = 4
    pitch_um: int = 10000
    mapping: str = "ROW_MAJOR_XY"
    geometry_id: str = ""
    geometry: Geometry | None = field(default=None, compare=False, repr=False)

    @property
    def count(self):
        return self.rows * self.cols

    def validate(self):
        if (type(self.rows) is not int or type(self.cols) is not int
                or not 1 <= self.rows <= 16 or not 1 <= self.cols <= 16
                or type(self.pitch_um) is not int or not 1000 <= self.pitch_um <= 30000
                or self.mapping not in ("ROW_MAJOR_XY", "EXPLICIT_XYZ")):
            raise ValueError("不支持的实际阵列尺寸、间距或通道映射")
        if self.mapping == 'EXPLICIT_XYZ':
            if not re.fullmatch('[0-9a-f]{24}', self.geometry_id):
                raise ValueError('三维阵列缺少有效几何标识')
            if self.geometry is not None and (self.geometry.validate().identity != self.geometry_id
                    or (self.rows, self.cols, self.pitch_um) != (self.geometry.rows, self.geometry.cols, self.geometry.pitch_um)):
                raise ValueError('三维阵列内容与设备声明不一致')
        elif self.geometry is not None or self.geometry_id:
            raise ValueError('自定义坐标必须使用三维阵列映射')
        return self

    def resolved_geometry(self):
        self.validate()
        if self.mapping == 'ROW_MAJOR_XY':
            return grid_geometry(self.rows, self.cols, self.pitch_um/1000)
        if self.geometry is None:
            raise ValueError('设备的三维阵列坐标尚未读取完整')
        return self.geometry

    @classmethod
    def from_geometry(cls, geometry):
        geometry.validate()
        return cls(geometry.rows, geometry.cols, geometry.pitch_um,
                   'EXPLICIT_XYZ', geometry.identity, geometry).validate()

    def wire(self):
        fields = dict(hw_rows=self.rows, hw_cols=self.cols, hw_pitch_um=self.pitch_um, mapping=self.mapping)
        if self.mapping == 'EXPLICIT_XYZ':
            fields['geometry_id'] = self.geometry_id
        return fields

    @classmethod
    def from_wire(cls, fields):
        return cls(int(fields["hw_rows"]), int(fields["hw_cols"]),
                   int(fields["hw_pitch_um"]), fields["mapping"],
                   fields.get('geometry_id', '') if fields['mapping'] == 'EXPLICIT_XYZ' else '').validate()


@dataclass(frozen=True)
class Workspace:
    """Firmware-declared command bounds, not a guarantee of tactile performance."""

    x_min_um: int = -100000
    x_max_um: int = 100000
    y_min_um: int = -100000
    y_max_um: int = 100000
    z_min_um: int = 20000
    z_max_um: int = 300000

    def validate(self):
        if any(type(value) is not int for value in asdict(self).values()):
            raise ValueError("工作空间边界须为整数微米")
        if not (-400000 <= self.x_min_um < self.x_max_um <= 400000
                and -400000 <= self.y_min_um < self.y_max_um <= 400000
                and 20000 <= self.z_min_um < self.z_max_um <= 300000):
            raise ValueError("工作空间范围无效")
        return self

    def wire(self):
        return asdict(self.validate())

    @classmethod
    def from_wire(cls, fields):
        return cls(**{name: int(fields[name]) for name in cls.__dataclass_fields__}).validate()

    def incompatibility(self, config):
        low, high = trajectory_bounds(config)
        minimum = np.array([self.x_min_um, self.y_min_um, self.z_min_um])
        maximum = np.array([self.x_max_um, self.y_max_um, self.z_max_um])
        if np.any(low < minimum) or np.any(high > maximum):
            return "图形的实际坐标超出设备声明的工作空间，请调整尺寸、位置或高度"
        return ""


@dataclass(frozen=True)
class Config:
    carrier_hz: int = 40000
    phase_steps: int = 64
    cx_um: int = 0
    cy_um: int = 0
    z_um: int = 150000
    radius_um: int = 20000
    repeat_millihz: int = 500
    mod_hz: int = 200
    level: int = 30
    shape: str = "CIRCLE"
    path_xy_um: str = "NONE"
    path_closed: int = 1
    scan_paths: str = "NONE"
    blank_us: int = 2000

    def validate(self):
        limits = {"carrier_hz": (20000, 80000), "phase_steps": (8, 256),
                  "cx_um": (-100000, 100000), "cy_um": (-100000, 100000),
                  "z_um": (20000, 300000), "radius_um": (0, 80000),
                  "repeat_millihz": (10, 200000), "mod_hz": (0, 1000), "level": (0, 100),
                  "path_closed": (0, 1), "blank_us": (100, 100000)}
        for name, (lo, hi) in limits.items():
            value = getattr(self, name)
            if type(value) is not int or not lo <= value <= hi:
                raise ValueError(f"{name} 必须是 {lo}～{hi} 的整数")
        if self.phase_steps not in (8, 16, 32, 64, 128, 256):
            raise ValueError("phase_steps 必须是 8、16、32、64、128 或 256")
        if self.shape not in SHAPES:
            raise ValueError("未知图形")
        points = self.points_um()
        strokes = self.strokes_um()
        if points and strokes:
            raise ValueError("不能同时指定旧路径和多段草图")
        if self.shape == "CUSTOM" and not (points or strokes):
            raise ValueError("请先绘制图形")
        if self.shape == 'CUSTOM' and strokes and self.blank_us*len(strokes)*self.repeat_millihz >= 1000000000:
            raise ValueError("轮廓切换时间不足，请降低重复频率或减少独立线段。")
        return self

    def strokes_um(self):
        return decode_strokes(self.scan_paths)

    def points_um(self):
        """Signed local x:y coordinate pairs, in integer micrometres."""
        if self.path_xy_um == "NONE":
            return ()
        if not isinstance(self.path_xy_um, str) or len(self.path_xy_um) > MAX_PATH_POINTS * 16:
            raise ValueError("自定义路径格式错误")
        tokens = self.path_xy_um.split(",")
        if not 1 <= len(tokens) <= MAX_PATH_POINTS:
            raise ValueError(f"最多支持 {MAX_PATH_POINTS} 个节点")
        if any(not re.fullmatch(r"-?[0-9]{1,6}:-?[0-9]{1,6}", token) for token in tokens):
            raise ValueError("路径应为整数微米坐标 x:y")
        points = tuple(tuple(map(int, token.split(":"))) for token in tokens)
        if any(abs(value) > 300000 for point in points for value in point):
            raise ValueError("节点距离图形中心不能超过 300 mm")
        if any(a == b for a, b in zip(points, points[1:])):
            raise ValueError("相邻路径节点不能重复")
        if self.path_closed and len(points) > 1 and points[0] == points[-1]:
            raise ValueError("闭合路径不必重复首节点")
        return points

    @classmethod
    def from_wire(cls, fields):
        values = {}
        for name in cls.__dataclass_fields__:
            if name not in fields:
                raise ValueError(f"缺少配置字段 {name}")
            value = fields[name]
            if name not in ("shape", "path_xy_um", "scan_paths"):
                # JSON booleans/floats must not silently become valid integers.
                if not (type(value) is int or isinstance(value, str) and value.lstrip("-+").isdigit()):
                    raise ValueError(f"{name} 必须是整数")
                value = int(value)
            values[name] = value
        return cls(**values).validate()

    def wire(self):
        self.validate()
        return asdict(self)


def encode_points(points):
    points = tuple(points)
    if any(len(point) != 2 or any(type(value) is not int for value in point) for point in points):
        raise ValueError("节点坐标须为整数微米")
    return ",".join(f"{x}:{y}" for x, y in points) if points else "NONE"


def encode_strokes(paths):
    result = "|".join(encode_points(path) for path in paths) if paths else "NONE"
    decode_strokes(result)
    return result


def decode_strokes(value):
    if value == "NONE":
        return ()
    if not isinstance(value, str) or len(value) > MAX_SCAN_POINTS*16:
        raise ValueError("草图路径格式无效")
    paths = []
    for raw in value.split('|'):
        tokens = raw.split(',')
        if any(not re.fullmatch(r'-?[0-9]{1,6}:-?[0-9]{1,6}', token) for token in tokens):
            raise ValueError("草图路径坐标无效")
        path = tuple(tuple(map(int, token.split(':'))) for token in tokens)
        if any(abs(v) > 300000 for point in path for v in point) or any(a == b for a, b in zip(path, path[1:])):
            raise ValueError("草图路径越界或存在重复相邻点")
        paths.append(path)
    if len(paths) > MAX_STROKES or sum(map(len, paths)) > MAX_SCAN_POINTS:
        raise ValueError("草图超出路径容量，请简化图形。")
    return tuple(paths)


def config_from_document(data):
    """Read coordinate files or migrate existing grid files without moving points."""
    if data.get("schema") == "haptics-config-3":
        return Config.from_wire(data["config"])
    if data.get("schema") == "haptics-config-2":
        return Config.from_wire(dict({'scan_paths': 'NONE', 'blank_us': 2000}, **data["config"]))
    if data.get("schema") != "haptics-config-1":
        raise ValueError("配置版本不支持")
    fields = dict(data["config"])
    rows, cols, pitch = (fields.pop(key) for key in ("rows", "cols", "pitch_um"))
    if (any(type(v) is not int for v in (rows, cols, pitch))
            or not 1 <= rows <= 65 or not 1 <= cols <= 65 or not 100 <= pitch <= 30000):
        raise ValueError("旧版图形的网格参数无效")
    nodes = fields.pop("path_nodes")
    points = []
    if nodes != "NONE":
        if not isinstance(nodes, str) or not re.fullmatch(r"[0-9]+(?:,[0-9]+)*", nodes):
            raise ValueError("旧版图形的节点编号无效")
        for node in map(int, nodes.split(",")):
            if not 0 <= node < rows * cols:
                raise ValueError("旧版图形的节点编号越界")
            r, c = divmod(node, cols)
            points.append((round((c - (cols-1)/2)*pitch), round((r - (rows-1)/2)*pitch)))
    fields["path_xy_um"] = encode_points(points)
    fields.setdefault('scan_paths', 'NONE')
    fields.setdefault('blank_us', 2000)
    return Config.from_wire(fields)


def array_coordinates(config):
    if not isinstance(config, ArraySpec):
        raise TypeError("阵元坐标必须来自实际 ArraySpec")
    return np.array(config.resolved_geometry().positions_mm)


def _polyline(points, fraction):
    points = np.asarray(points, dtype=float)
    lengths = np.linalg.norm(np.diff(points, axis=0), axis=1)
    if not len(lengths) or lengths.sum() == 0:
        return points[0]
    distance = (fraction % 1) * lengths.sum()
    accum = 0.0
    for i, length in enumerate(lengths):
        if length > 0 and distance <= accum + length:
            return points[i] + (points[i + 1] - points[i]) * ((distance - accum) / length)
        accum += length
    return points[-1]


def trajectory_point(config, seconds):
    if config.shape == "CUSTOM" and config.scan_paths != "NONE":
        return trajectory_sample(config, seconds)[0]
    fraction = seconds * config.repeat_millihz / 1000 % 1
    r = config.radius_um / 1000
    if config.shape == "CUSTOM":
        points = config.points_um()
        if not points:
            raise ValueError("自定义路径尚未定义")
        points = np.asarray(points, dtype=float) / 1000
        if config.path_closed:
            points = np.vstack((points, points[0]))
        else:
            # Open strokes retrace their route; no unexplained jump or closing edge.
            points = np.vstack((points, points[-2::-1]))
        xy = _polyline(points, fraction)
        return np.array([config.cx_um / 1000 + xy[0], config.cy_um / 1000 + xy[1], config.z_um / 1000])
    if config.shape == "POINT":
        xy = np.array([0.0, 0.0])
    elif config.shape == "CIRCLE":
        xy = np.array([math.cos(2 * math.pi * fraction), math.sin(2 * math.pi * fraction)])
    elif config.shape in ("LINE_X", "LINE_Y"):
        position = 1 - 4 * abs(fraction - 0.5)
        xy = np.array([position, 0.0] if config.shape == "LINE_X" else [0.0, position])
    elif config.shape == "TRIANGLE":
        xy = _polyline([(0, 1), (-0.866, -0.5), (0.866, -0.5), (0, 1)], fraction)
    elif config.shape == "SQUARE":
        xy = _polyline([(-1, -1), (1, -1), (1, 1), (-1, 1), (-1, -1)], fraction)
    else:
        xy = _polyline([(-1, 0), (1, 0), (0.3, 0.7), (1, 0), (0.3, -0.7),
                        (1, 0), (-1, 0)], fraction)
    return np.array([config.cx_um / 1000 + r * xy[0],
                     config.cy_um / 1000 + r * xy[1], config.z_um / 1000])


def trajectory_path(config, samples=121):
    if config.shape == "CUSTOM" and config.scan_paths != "NONE":
        paths = trajectory_paths(config)
        return np.concatenate([np.vstack((path, np.full((1, 3), np.nan))) for path in paths])[:-1]
    period = 1000 / config.repeat_millihz
    return np.array([trajectory_point(config, t) for t in np.linspace(0, period, samples)])


def trajectory_paths(config):
    if config.shape == 'CUSTOM' and config.scan_paths != 'NONE':
        return [np.column_stack((np.array(path)/1000+np.array([config.cx_um, config.cy_um])/1000,
                                 np.full(len(path), config.z_um/1000))) for path in config.strokes_um()]
    return [trajectory_path(config)]


def trajectory_sample(config, seconds):
    """Return focus, scan gate and stroke index, including output-off transfers."""
    if config.shape != 'CUSTOM' or config.scan_paths == 'NONE':
        return trajectory_point(config, seconds), True, 0
    paths = trajectory_paths(config)
    period = 1000/config.repeat_millihz
    blank = config.blank_us/1000000
    active = period-len(paths)*blank
    weights = [max(.1, float(np.linalg.norm(np.diff(path, axis=0), axis=1).sum())) for path in paths]
    offset = seconds % period
    for index, (path, weight) in enumerate(zip(paths, weights)):
        duration = active*weight/sum(weights)
        if offset < duration:
            return _polyline(path, offset/duration), True, index
        offset -= duration
        if offset < blank:
            following = paths[(index+1) % len(paths)][0]
            return path[-1]+(following-path[-1])*(offset/blank), False, index
        offset -= blank
    return paths[0][0], True, 0


def trajectory_bounds(config):
    """Exact conservative envelope in um; do not miss extrema by sampling."""
    config.validate()
    if config.shape == "CUSTOM":
        xy = np.asarray([point for path in config.strokes_um() for point in path]
                        if config.scan_paths != 'NONE' else config.points_um())
        low, high = xy.min(axis=0), xy.max(axis=0)
    else:
        r = config.radius_um
        spans = {"POINT": (0, 0), "LINE_X": (r, 0), "LINE_Y": (0, r),
                 "CIRCLE": (r, r), "SQUARE": (r, r), "TRIANGLE": (.866*r, r), "ARROW": (r, .7*r)}
        dx, dy = spans[config.shape]
        low = np.array([-dx, -dy if config.shape != "TRIANGLE" else -.5*r])
        high = np.array([dx, dy])
    center = np.array([config.cx_um, config.cy_um])
    return np.r_[low + center, config.z_um], np.r_[high + center, config.z_um]


def focus_phases(config, focus_mm, array):
    """Quantized modulo-period delay codes for the documented phasor convention."""
    r = np.linalg.norm(array_coordinates(array) - np.asarray(focus_mm), axis=1) / 1000
    cycles = np.remainder(-r * config.carrier_hz / (array.resolved_geometry().sound_speed_mm_s/1000), 1.0)
    return (np.floor(cycles * config.phase_steps + 0.5).astype(int) % config.phase_steps)


def field_slice(config, phases, focus_mm, *, array, enabled=True, resolution=71, plane="XY", channel_mask=None):
    """Return normalized |p|, NOT Pa, SPL, tactile intensity or modulation envelope.

    The normalization uses ideal coherent pressure at the specified target for
    unit drive. Thus disabled/zero-level output remains zero, not re-normalized.
    'level' is a hypothetical linear source scale, not a voltage calibration.
    """
    phases = np.asarray(phases, dtype=float)
    if phases.shape != (array.count,) or not np.isfinite(phases).all():
        raise ValueError("相位表长度或数值无效")
    if np.any(phases < 0) or np.any(phases >= config.phase_steps):
        raise ValueError("相位值越界")
    coords = array_coordinates(array)
    focus = np.asarray(focus_mm, dtype=float)
    if focus.shape != (3,) or not np.isfinite(focus).all() or focus[2] <= 0:
        raise ValueError("焦点坐标无效")
    low, high = trajectory_bounds(config)
    span = max(45.0, float(np.abs(coords[:, :2]).max()) + 20,
               abs(focus[0]) + 25, abs(focus[1]) + 25,
               np.abs(np.r_[low[:2], high[:2]]).max() / 1000 + 15)
    horizontal = np.linspace(-span, span, resolution)
    vertical = (np.linspace(-span, span, resolution) if plane == "XY" else
                np.linspace(10, max(240, focus[2] + 50), resolution))
    xx, vv = np.meshgrid(horizontal, vertical)
    yy, zz = (vv, np.full_like(xx, focus[2])) if plane == "XY" else (np.full_like(xx, focus[1]), vv)
    pressure = np.zeros_like(xx, dtype=np.complex128)
    k = 2 * math.pi * config.carrier_hz / (array.resolved_geometry().sound_speed_mm_s/1000)
    if enabled and config.level:
        for i, ((x, y, z), phase) in enumerate(zip(coords, phases)):
            if channel_mask is not None and not (channel_mask >> i) & 1:
                continue
            distance = np.maximum(.0001, np.sqrt((xx - x) ** 2 + (yy - y) ** 2 + (zz-z) ** 2) / 1000)
            pressure += np.exp(1j * (k * distance + phase * 2 * math.pi / config.phase_steps)) / distance
    reference = np.sum(1000 / np.maximum(.1, np.linalg.norm(coords - focus, axis=1)))
    values = np.abs(pressure) / reference * config.level / 100
    return horizontal, vertical, values
