Cody-ic/fpga-air-haptics/(commit log)

2026-09-24 fix: show confirmed playback and expose basic patterns
    [app.py, demo.py, editor.py, model.py, playback.py, presets.py]
2026-09-24 fix: expose baud rate in normal connection controls
    [app.py]
2026-09-26 feat: upgrade FPGA firmware path to the HAP3 wire protocol
2026-09-26 pcb: prepare 4x4 R5 fabrication package
    [BOM.csv, Haptics_4x4_R5_12VDC.epro, Positions.csv]
2026-09-26 docs: disambiguate trajectory beat table from circuit timing
2026-09-26 feat: wire the sketch trajectory into the command layer and add the firmware top
2026-09-26 docs: record how the trajectory is wired through the firmware top
2026-09-26 docs: note the known boundaries and the real board top module
2026-09-26 feat: add ultrasonic output stage (phase codes to 16 square waves)
2026-09-28 feat: add receiver ADC capture and desktop waveform view
2026-09-29 feat: add printable wrist support and 4x4 alignment jig
2026-09-30 feat: support 3D array geometry and receiver phase calibration
2026-09-30 hardware: refine coplanar soldering jig and release P2 models
2026-09-30 hardware: remove PCB support posts from alignment jig
2026-10-03 fix: correct dead-time logic and force a phase sweep after config change
    [hap2_phase.v]
2026-10-04 feat: generate preset shapes on the board and fix the beat-table capacity bug
    - add hap2_shape (7 shapes -> vertex table) and hap2_pt_table (its own point table)
    - hap2_cmd: P_SHAPE pending state; hap2_top: generate from the shadow config
    - fix a real bug: the beat-table arrays were sized 2*MAX_MV instead of 2*512,
    so rows past 64 of the second half were written out of bounds and silently
    dropped -- a 128-row circle froze when the focus reached the far left
    - tb_traj: add a 129-point single stroke to pin that case; tb_hap2_rx: stub the
    trajectory handshake that the new P_SHAPE state waits on
    - tb_hap2_top: preset circle now checked end to end (scan_on, radius, motion)
    - gen_vectors: st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
    [hap2_top.v]
2026-10-06 feat: board bring-up layer, local keys, workspace check, level/modulation
    Items 1-9 of the pre-board checklist:
    - board_top.v + fpga/board/{cst,sdc,README}: POR, boot id, keys, status LEDs,
    Tang Mega 60K pins (clock V22 50 MHz verified from Sipeed examples)
    - por_reset.v: async assert / sync release, 10 ms power-on hold
    - hap2_local.v: 20 ms key debounce, shape cycling, play/pause/stop
    - OUT_OF_WORKSPACE: bbox from sketch points or preset centre+-radius,
    checked against the declared workspace; local keys drive the same flow
    - level -> duty-cycle amplitude, mod_hz -> envelope gating in hap2_out
    - 8x8 end-to-end pre-run (tb_top8) + phase timing budget in tb_phase
    Real bugs found and fixed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
    [hap2_top.v]
2026-10-07 hardware: add fixed vertical fixtures and archive PCB revisions
    [Haptics_4x4_R3_12VDC.epro, Haptics_4x4_R3_20260926.epro, Haptics_4x4_R4_12VDC.epro]
2026-10-07 docs: tidy archived PCB report formatting
2026-10-07 feat: add F103 CubeIDE firmware and serial measurement logging
    [haptics_f103c8.cfg]
2026-10-08 hardware: add manually routed 8x8 transmitter and release checks
    [BOM.csv, Positions.csv]
2026-10-08 fix: audit 8x8 copper and correct Gerber export
2026-10-08 hardware: tighten buck input loop and clock returns
    [Positions.csv]
2026-10-09 fix: bound F103 startup and isolate channel diagnostics
    [app_f103.c, app_f103.h, haptics.h, wave_driver_harness.c]
2026-10-09 fix: align F103 pulse gates and use static channel diagnostics
    [app_f103.c, app_f103.h, wave_driver_harness.c, wave_f103.c]
2026-10-09 feat: add parameterized fixed-pin diagnostics
    [app_f103.c, app_f103.h]
2026-10-09 fix: keep fixed-pin diagnostics running until stopped
    [app_f103.c]
2026-10-09 fix: unify F103 mode selection and serial status logging
    [haptics.h]
2026-10-10 feat: add macro-configured F103 fixed-focus business mode
    [app_f103.c, app_f103.h, business_focus_driver_harness.c, wave_driver_harness.c, wave_f103.c]
2026-10-12 fix: make the design build in Gowin and run the first synthesis + PnR
    First full build (syn + place&route + bitstream) completed on GW5AT-LV60PG484A:
    LUT 8590/59904 (14%), FF 5886, BSRAM 24, DSP 24/118.
    Runtime paths all meet 50 MHz; the config-stage planner does not (25 setup
    violations, worst -13.5 ns) -- that is the next fix.
    Code fixes forced by the stricter synthesizer / found while building:
    - hap2_cmd: ws_ok must not be a zero-input function (Gowin EX3808) -> comb logic
    - hap2_traj_scan: pt_addr is driven by an instance output, must be a wire
    (EX3805); walk_fx/fy/scan/stroke declared before use (EX3638)
    - hap2_traj_scan: txt_ram had two write statements and wrote four bytes in one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
2026-10-12 docs: prepare the 16-channel constraint switch and record the multipurpose-pin finding
    Tried to free the dual-purpose pins from the command line (the 4 PMOD balls
    D04-D07 and the EMCCLK clock ball): neither -bg_programming values nor editing
    IDE/share/config/device.cfg (DOWNLOAD_MODE default JTAG_AUTO_BOOT -> JTAG)
    changes the placement result -- PR2017 'dedicated pin (CPU)' persists, and the
    device.cfg edit was reverted. So this really has to be done in the IDE dialog.
    board/tang_mega_60k.cst now carries the 16-channel mapping commented out with
    the exact steps to switch (IDE Multipurpose Pin -> Download Mode = JTAG, then
    uncomment + set HW_ROWS back to 4).
2026-10-12 feat: 16-channel (4x4) build via -use_cpu_as_gpio, plus the multipurpose-pin finding
    Solution A is solved from the command line after all: gw_sh has
    set_option -use_cpu_as_gpio 1
    which frees the D00-D15 configuration pins. Verified on a minimal project
    (PR2017 -> 0, generated device.cfg shows 'set CPU regular_io = true') and then on
    the real design: 16 channels place and route and the bitstream is generated.
    - build.tcl: add the option with the reasoning
    - tang_mega_60k.cst: back to the 16-channel mapping (two PMODs + camera port),
    UART/LEDs moved to clean pins (25 pins, no duplicates)
    - board_top: HW_ROWS back to 4; tb_board/tb_review_edges follow (16-bit array)
    - 11 testbenches, 7013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
2026-10-12 perf: register the duty-cycle threshold, and pulse cfg_change in tb_out
    The 16-channel timing report showed 7 of the 8 worst paths going
    cfg_level -> 56-bit multiply -> 16 comparators -> out_pos (worst -2.89 ns).
    duty_thr is now computed into a register on cfg_change, so the runtime path is
    only 'add phase offset, compare'.
    tb_out changed level without pulsing cfg_change, which the real system always
    does (level arrives with CONFIG); the testbench now behaves the same, and the
    29 output-stage checks pass again.
    Still to do: pipeline the planner's bstroke * seg_len multiply (-2.895 ns) and
    decide on the PLL for the clock (PR1014).
2026-10-12 perf: cut the two biggest timing clusters (divider counter, output duty)
    16-channel build, before -> after (same place-and-route flow):
    worst slack -2.895 ns -> -1.648 ns
    u_aconst (20 paths, 56-bit borrow chain) -> gone
    out_pos (7 paths, level -> duty compare) -> gone
    PR1014 (clock on generic routing) -> gone
    LUT 9668 -> 8787
    - fix_div: the countdown register only needs 6 bits (0..55); writing it
    NUM_BITS wide made a 56-bit borrow chain
    - hap2_out: duty_thr is registered and recomputed on cfg_change or a level
    change (the leader's edge-case testbench drove level without cfg_change)
    - hap2_traj_plan: the segment-beat divide is now three cycles
    (read table -> mu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
2026-10-13 perf: judge key names one cycle later, so the compare chain ends at a register
    The 21 u_parse/key_buf violations (19 parallel 128-bit comparators feeding a
    19-way priority chain) are gone: key_hit is registered (hit_any_q/hit_id_q) and
    the FSM decides in a new S_KEYJ state one cycle later. key_buf is stable while
    waiting for '=', so nothing is lost. Verified first with tb_hap2_rx alone, then
    with all 11 testbenches (green).
    Timing after this change: 25 -> 12 violating paths, u_parse/key_buf 21 -> 0,
    u_aconst/out_pos still 0. But the worst slack went from -1.648 to -4.025 ns, now
    all in the planner (sh_blank_us x10, u_tx x2) -- that cluster is the last one
    left, and likely needs the blank_us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
2026-10-13 perf: compute blank_beats on the shared divider -- timing is now clean
    Last cluster (sh_blank_us x10, worst -4.025 ns) came from blank_us/10 being a
    constant division with a wide fan-out on cfg_blank_us. It now runs on the shared
    divider (new S_BLKW state, before the laps division, because blank_beats takes
    part in the reject decisions).
    Result: 0 violating paths, worst slack 0 (was 25 paths / -1.648 ns before this
    round, -4.025 ns in the middle of it). Verified with tb_traj alone (3559 checks,
    tables and reject paths) and then all 11 testbenches, all green.
    Timing history on the 16-channel design:
    first build: 25 paths, worst -2.895 ns, PR1014 clock warning
    + divider counter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
2026-10-14 board: retarget the project to Tang MEGA 138K Pro (676-ball FCPBG676A)
    The board is a Tang MEGA 138K Pro: same die as the 138K we had, but the package is FCPBG676A (676 balls) instead of PBGA484A, and none of the old ball names mean anything here. Every pin is re-derived from official Sipeed material (full-pin constraint, dock schematics, BTB pin table, key/LED examples), all downloaded into fpga/board/docs/.
    Clock moves to P16: that is the 50 MHz oscillator on this board, while V22 is a second 70 MHz oscillator. Keys K16/F15/G15, array outputs on PMOD1 + PMOD2 (PMOD0 skipped because the official pin table and the schematic disagree on one of its pins). Serial now comes from the on-board de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
2026-10-14 docs: record the first successful 138K Pro build (676-ball, no timing violations)
    Commercial IDE V1.9.12.04 builds the design for GW5AST-LV138FPG676A: bitstream board_top.fs is generated, all 25 pins land exactly where tang_mega_138k_pro.cst puts them, and timing closes with 0 violations (worst setup slack +2.912 ns). The one remaining warning is the old PR1014 clock-routing note. Nothing has been tested on hardware yet.
2026-10-14 fix: correct FPGA focus phase and R5 array pitch
2026-10-14 docs: record why flashing hung at 0% on this PC (debugger channel vs USB location)
    The board, the cable and the bitstream were all fine. The on-board BL616 debugger enumerates as an FTDI dual-channel device, and Gowin picks the UART interface (USB location 562 here) by default; JTAG sits on the other interface (location 561). Scanning with an explicit --location 561 immediately finds the chip and reports ID 0x0001081B, which confirms device version B. Documents both the GUI fix (Cable Setting -> Query -> pick location 561) and the CLI one-liner.
2026-10-14 docs: clarify programmer location and device revision checks
2026-10-14 docs: propose position-aware receiver calibration
2026-10-20 fix: expand school print orders by piece count
2026-10-20 docs: add spare parts and explicit print file mappings
2026-10-22 docs: add minimal print-only fixture handoff
2026-10-25 feat: add fixed 20mm receiver tray and film stand lifts
